nichlock/open-linear-scale/docs/4-layer-sensor-noise-raw.png

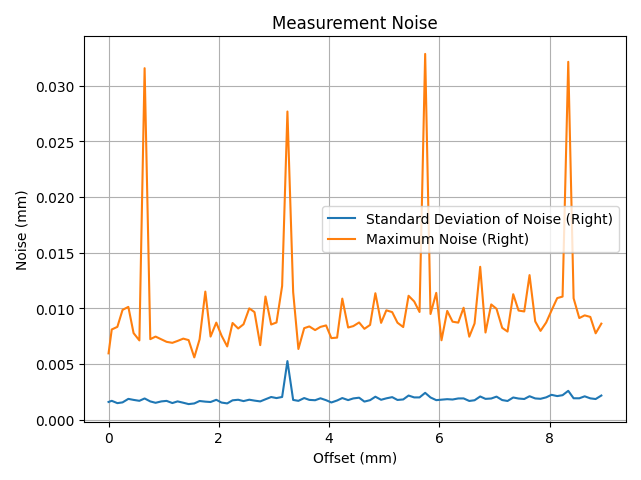
docs/4-layer-sensor-noise-raw.png
