nichlock/open-linear-scale/docs/bare-sensor-top.jpg

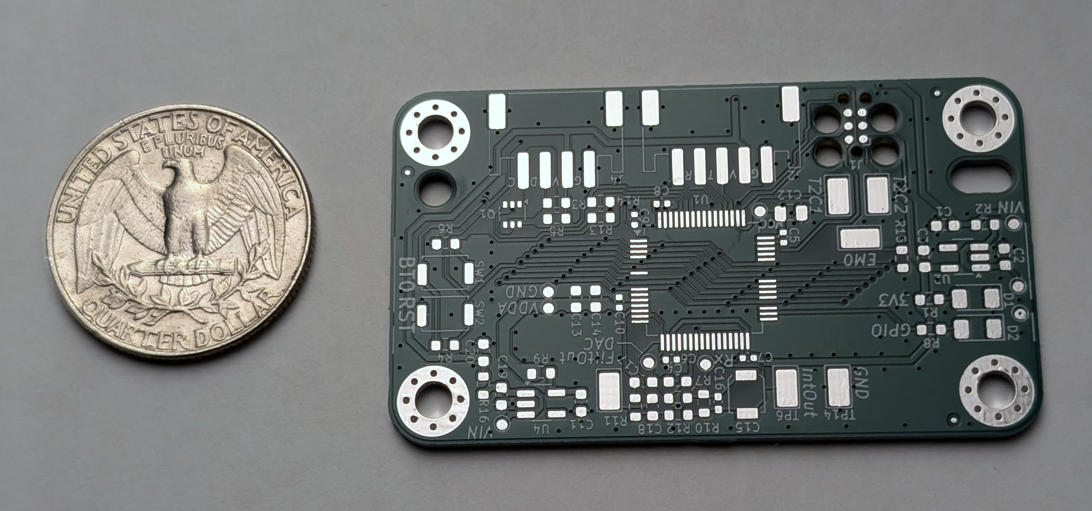
docs/bare-sensor-top.jpg
