nichlock/open-linear-scale/docs/header-bg-removed.png

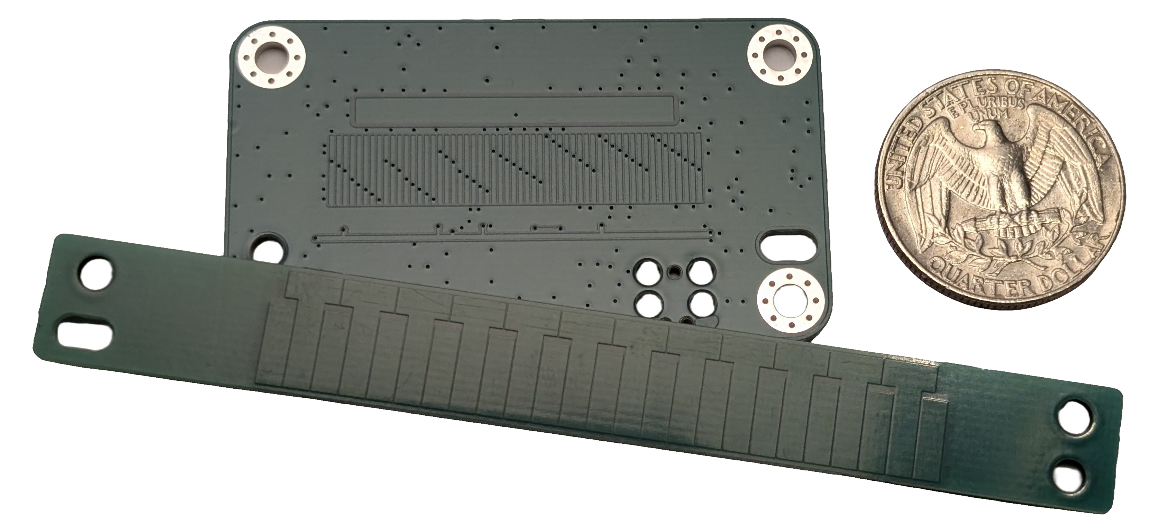
docs/header-bg-removed.png
