nichlock/open-linear-scale/docs/header-no-bg-removed.png

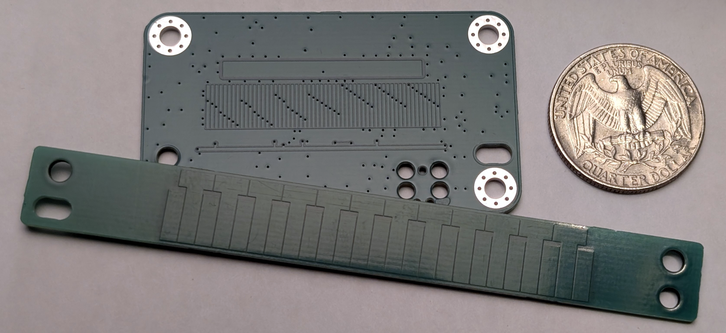
docs/header-no-bg-removed.png
