nichlock/open-linear-scale/docs/overlap/detail.png

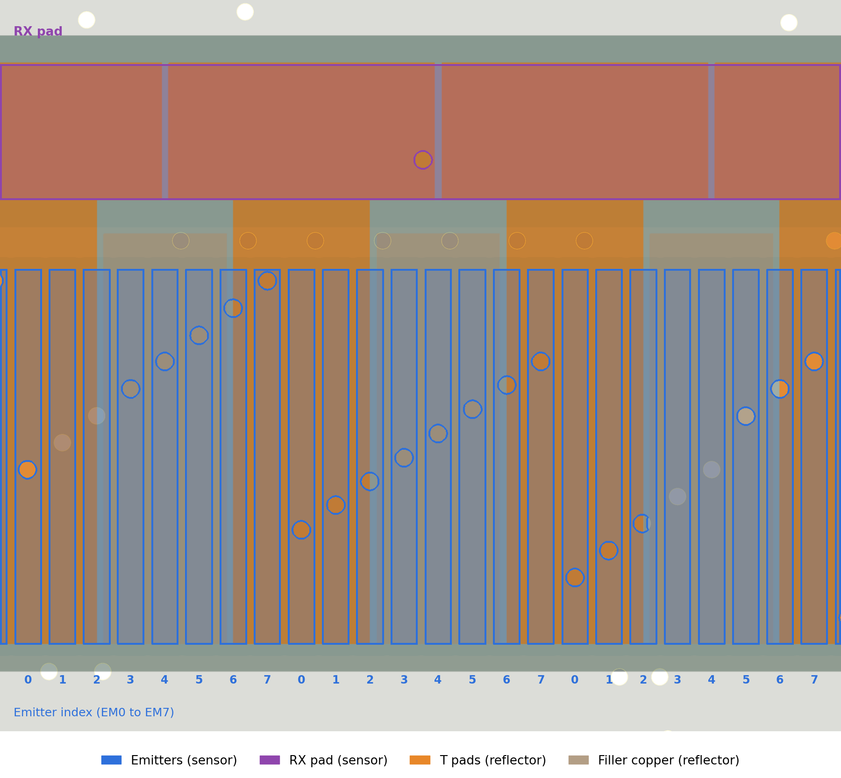
docs/overlap/detail.png
