nichlock/open-linear-scale/docs/overlap/reflector-pad-side.png

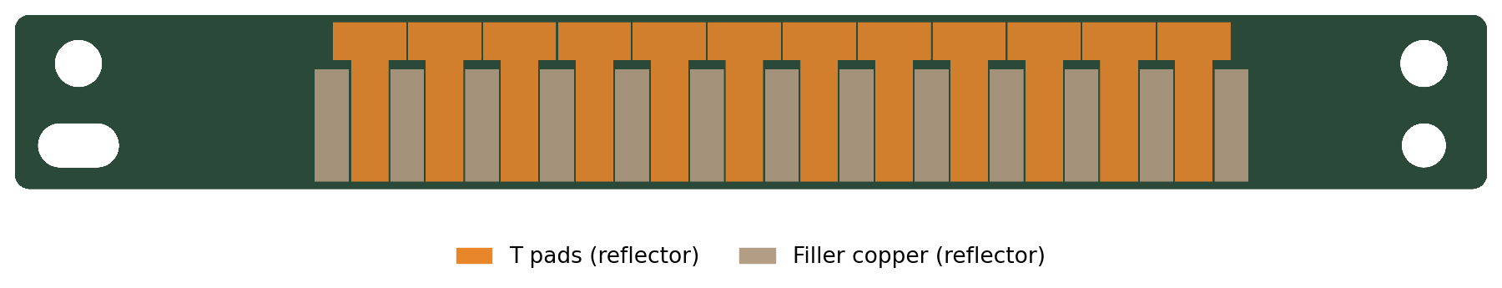
docs/overlap/reflector-pad-side.png
