nichlock/open-linear-scale/docs/overlap/sensor-grid-side.png

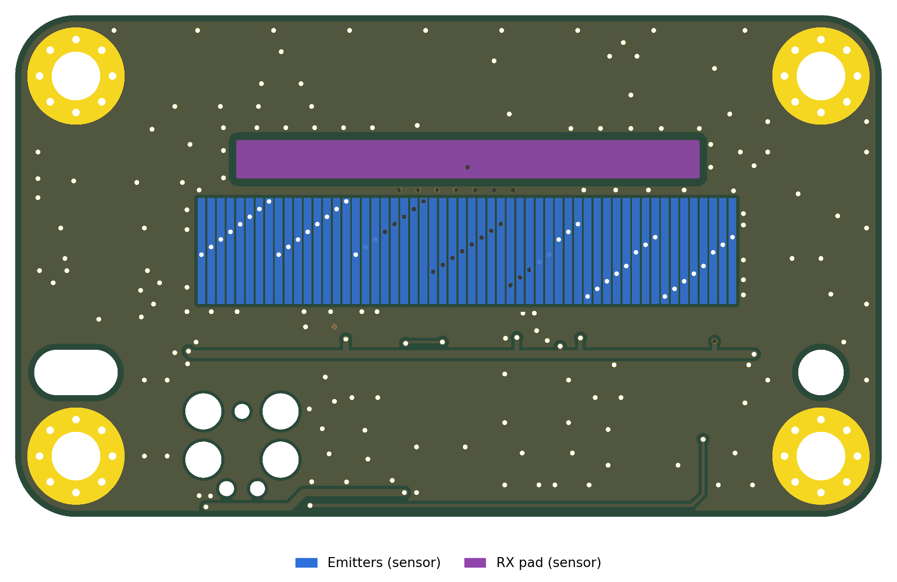
docs/overlap/sensor-grid-side.png
