nichlock/open-linear-scale/docs/pinout/sensor-pinout.png

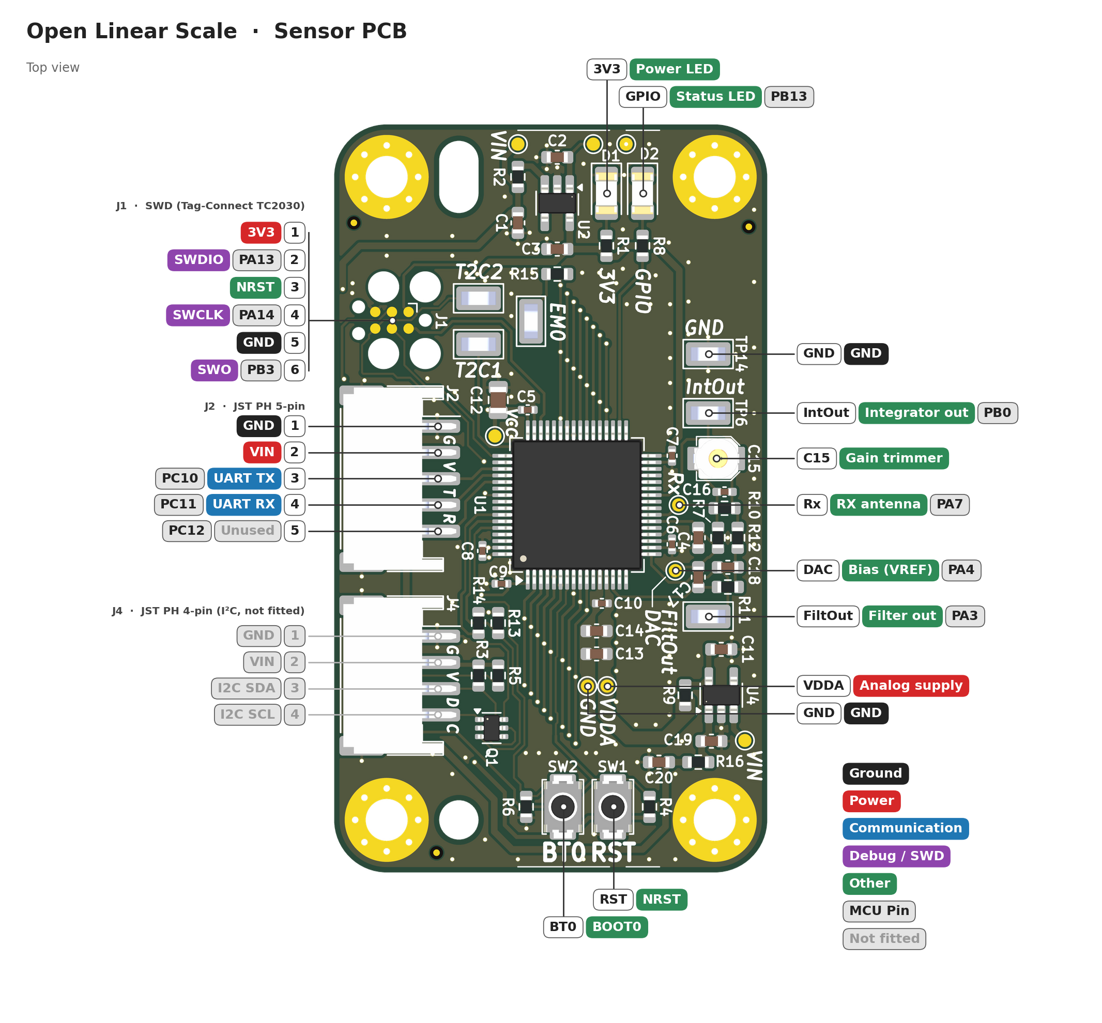
docs/pinout/sensor-pinout.png
