nichlock/open-linear-scale/docs/plots/emitter-state-transitions.png

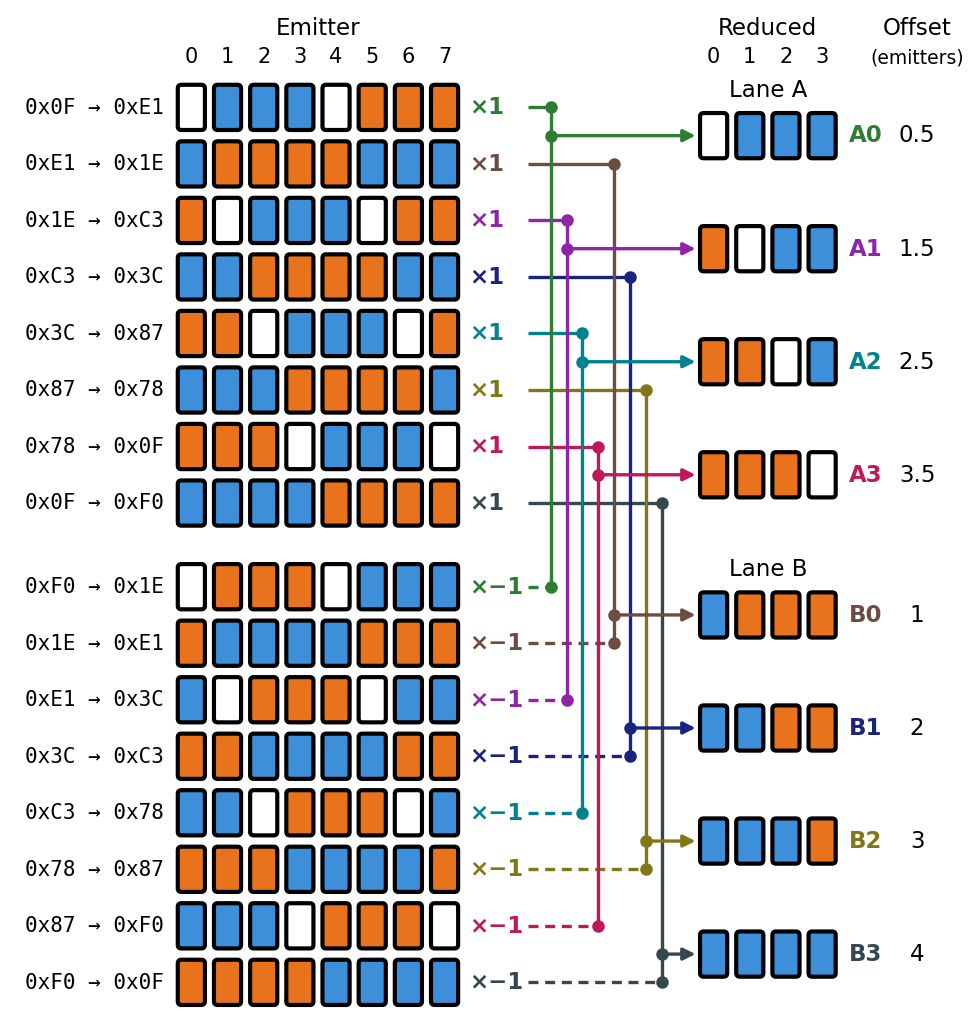
docs/plots/emitter-state-transitions.png
