nichlock/open-linear-scale/docs/sensor-pcb-bot-quarter.jpg

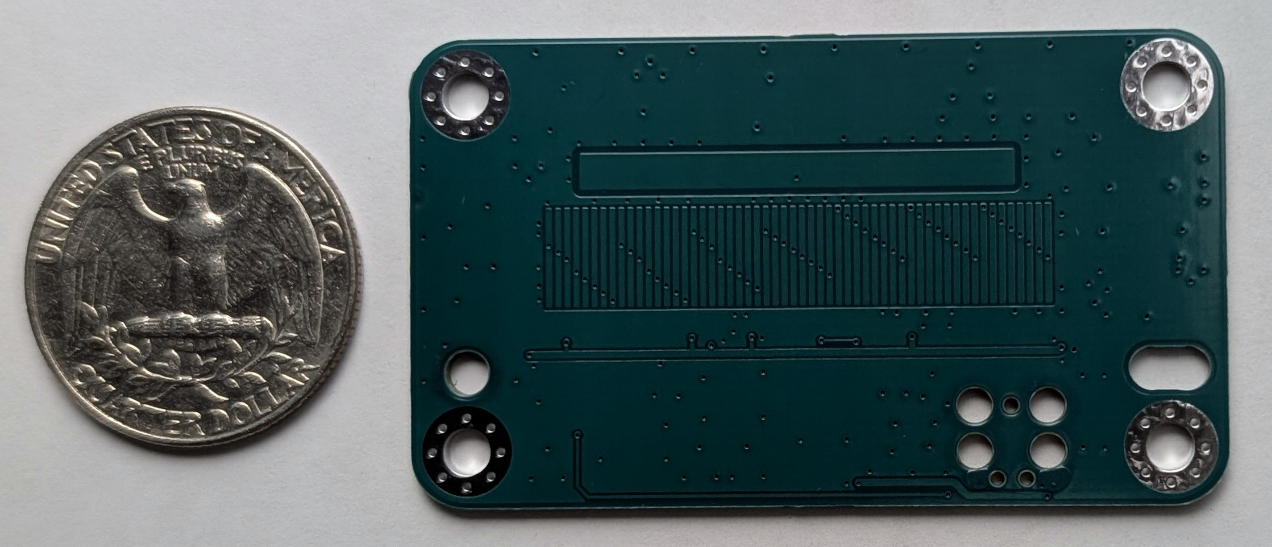
docs/sensor-pcb-bot-quarter.jpg
