nichlock/open-linear-scale/docs/sensor-pcb-bot.jpg

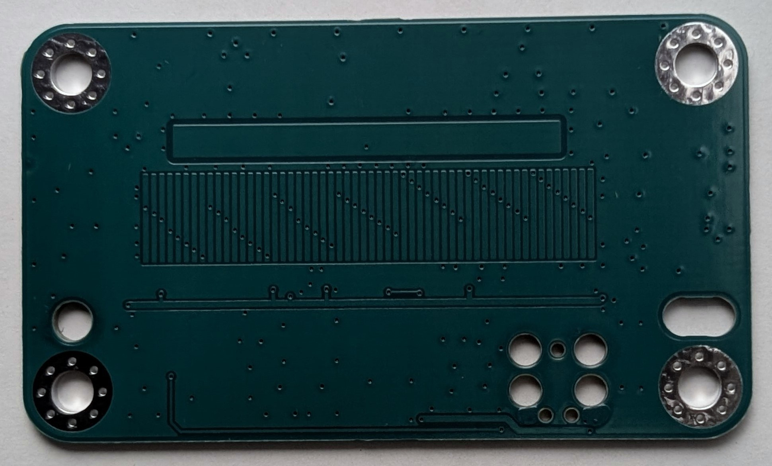
docs/sensor-pcb-bot.jpg
