nichlock/open-linear-scale/hardware/sensor-pcb/sensor-pcb.csv

# | Reference | Qty | Value | DNP | Footprint | MFPN | Digi-Key PN | Notes
1 | C1,C2,C3,C4,C11,C13,C14,C19,C20 | 9 | 1uF |  | Capacitor_SMD:C_0603_1608Metric | GCM188R71E105KA64D | 490-10673-1-ND
2 | C5,C6,C7,C8,C9,C10 | 6 | 0.1uF |  | Capacitor_SMD:C_0402_1005Metric | GCM155R71C104KA55D | 490-4759-1-ND
3 | C12 | 1 | 4.7uF |  | Capacitor_SMD:C_0805_2012Metric | GCM21BR71C475KA73L | 490-5332-1-ND
4 | C15 | 1 | JR030 |  | JRx-trimmer:JRx-trimmer | JR030 | 1674-1015-1-ND
5 | C16 | 1 | 1pF | DNP | Capacitor_SMD:C_0402_1005Metric_Pad0.74x0.62mm_HandSolder | GCM1555C1H1R0CA16J | 490-17745-1-ND
6 | C17 | 1 | 1.1nF |  | Capacitor_SMD:C_0603_1608Metric | GCM1885G1H112FA16D | 490-GCM1885G1H112FA16DCT-ND
7 | C18 | 1 | 2.2nF |  | Capacitor_SMD:C_0603_1608Metric | GCM1885C1H222FA16D | 490-16421-1-ND
8 | D1 | 1 | APT3216LZGCK |  | LED_SMD:LED_1206_3216Metric | APT3216LZGCK | 754-1944-1-ND
9 | D2 | 1 | APT3216LSECK/J3-PRV |  | LED_SMD:LED_1206_3216Metric | APT3216LSECK/J3-PRV | 754-1940-1-ND
10 | J2 | 1 | S5B-PH-SM4-TB |  | Connector_JST:JST_PH_S5B-PH-SM4-TB_1x05-1MP_P2.00mm_Horizontal | S5B-PH-SM4-TB | 455-S5B-PH-SM4-TBCT-ND
11 | J4 | 1 | S4B-PH-SM4-TB | DNP | Connector_JST:JST_PH_S4B-PH-SM4-TB_1x04-1MP_P2.00mm_Horizontal | S4B-PH-SM4-TB | 455-S4B-PH-SM4-TBCT-ND
12 | M1 | 1 | PHR-5 |  |  | PHR-5 | 455-1163-ND
13 | M2,M3,M4,M5,M6 | 5 | ASPHSPH24K102 |  |  | ASPHSPH24K102 | 455-3358-ND | You can buy kits of knock-off JST PH parts, but I chose to buy the official pre-crimped wires.
14 | Q1 | 1 | BSS138BKSH | DNP | Package_TO_SOT_SMD:SOT-363_SC-70-6 | BSS138BKSH | 1727-7841-1-ND
15 | R1,R8 | 2 | 510 |  | Resistor_SMD:R_0603_1608Metric | CRCW0603510RFKEA | 541-510HCT-ND
16 | R2,R9,R16 | 3 | 0R |  | Resistor_SMD:R_0603_1608Metric | CRCW06030000Z0EA | 541-0.0GCT-ND
17 | R3,R5,R13,R14 | 4 | 10k | DNP | Resistor_SMD:R_0603_1608Metric | CRCW060310K0FKEA | 541-10.0KHCT-ND
18 | R4,R6 | 2 | 5.1k |  | Resistor_SMD:R_0603_1608Metric | CRCW06035K10FKEA | 541-5.10KHCT-ND
19 | R7 | 1 | 680k |  | Resistor_SMD:R_0603_1608Metric | CRCW0603680KFKEA | 541-680KHCT-ND
20 | R10 | 1 | 100M |  | Resistor_SMD:R_0603_1608Metric | CRCW0603100MJPEAHR | 541-100MAHCT-ND
21 | R11,R12,R15 | 3 | 10k |  | Resistor_SMD:R_0603_1608Metric | CRCW060310K0FKEA | 541-10.0KHCT-ND
22 | SW1,SW2 | 2 | SKRKAHE020 |  | Button_Switch_SMD:SW_Push_SPST_NO_Alps_SKRK | SKRKAHE020 | 4809-SKRKAHE020CT-ND
23 | TP6,TP8,TP10,TP12,TP14,TP17 | 6 | TP_Keystone_5015 |  | TestPoint:TestPoint_Keystone_5015_Micro_Mini | 5015 | 36-5015CT-ND
24 | U1 | 1 | STM32L476RCTx |  | Package_QFP:LQFP-64_10x10mm_P0.5mm | STM32L476RCT6 | 497-17541-ND
25 | U2,U4 | 2 | AP7354-33W5-7 |  | Package_TO_SOT_SMD:SOT-23-5_HandSoldering | AP7354-33W5-7 | AP7354-33W5-7DICT-ND
