nichlock/open-linear-scale/mechanical/Full Reflector 0.1mm.stl

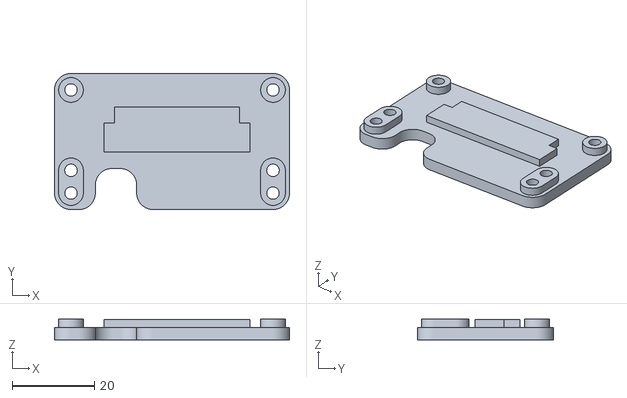
[picture p38: CAD file, 2026-10-06]
mechanical/Full Reflector 0.1mm.stl
57.0 x 33.0 x 5.00
