nichlock/open-linear-scale/mechanical/Full Reflector 0.3mm.stl

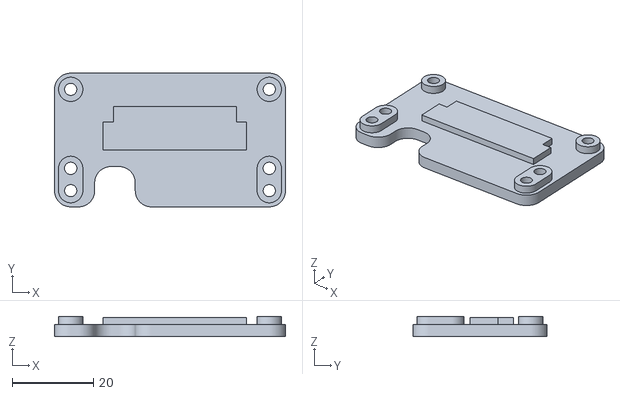
[picture p39: CAD file, 2026-10-06]
mechanical/Full Reflector 0.3mm.stl
57.0 x 33.0 x 5.00
