nichlock/open-linear-scale/hardware/reflector-pcb-sm/exports/reflector-pcb-sm.step

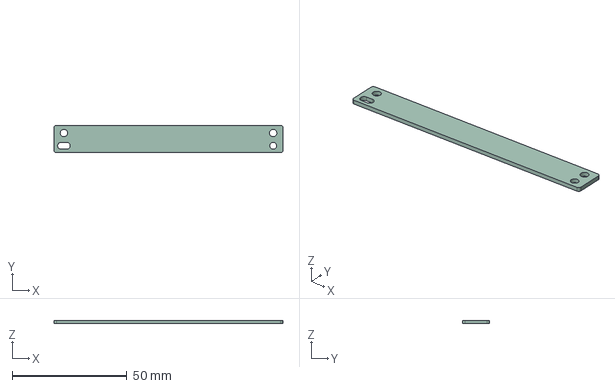
[picture p40: CAD file, 2026-10-12]
hardware/reflector-pcb-sm/exports/reflector-pcb-sm.step
99.8 x 11.8 x 1.51 mm
