nichlock/open-linear-scale/hardware/sensor-pcb/exports/sensor-pcb.step

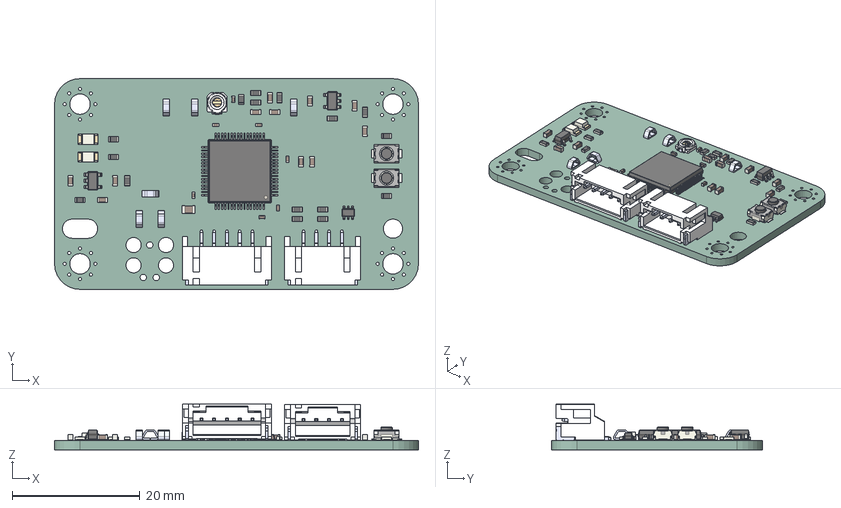
[picture p41: CAD file, 2026-10-13]
hardware/sensor-pcb/exports/sensor-pcb.step
57.0 x 33.0 x 7.19 mm
C_0603_1608Metric x 11
R_0603_1608Metric x 16
SxB-PH-SM4-TB white_4
C_0402_1005Metric x 7
SOT-363_SC-70-6
LED_1206_3216Metric x 2
SW_Push_SPST_NO_Alps_SKRK x 2
LQFP-64_10x10mm_P0.5mm
SOT-23-5 x 2
S5B-PH-SM4-TB
JR200
C_0805_2012Metric
sensor-pcb_PCB
