nichlock/open-linear-scale/mechanical/calibration-prusa/Indicator-Clamp.stl

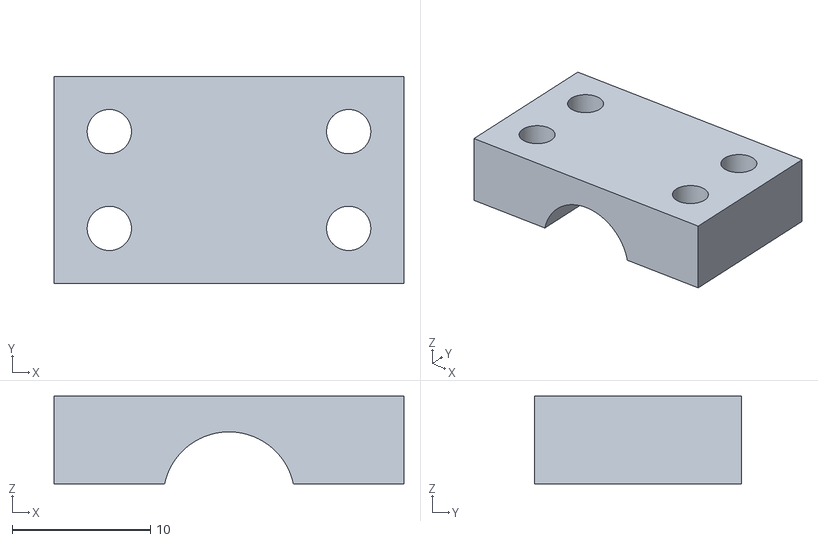
[picture p42: CAD file, 2026-10-11]
mechanical/calibration-prusa/Indicator-Clamp.stl
25.3 x 15.0 x 6.34
