nichlock/open-linear-scale/mechanical/calibration/Rear Bracket.stl

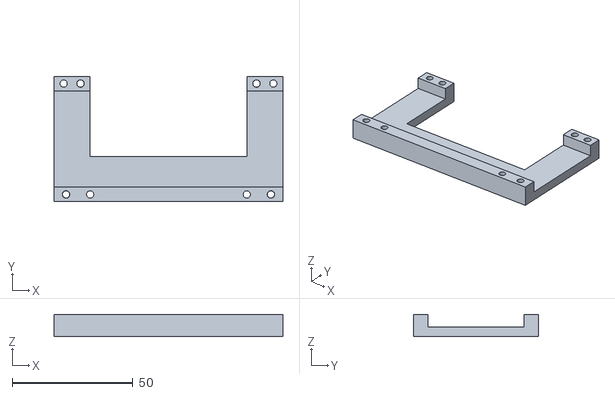
[picture p43: CAD file, 2026-10-04]
mechanical/calibration/Rear Bracket.stl
95.0 x 52.0 x 9.20
