nichlock/open-linear-scale/mechanical/freestanding/Shim.stl

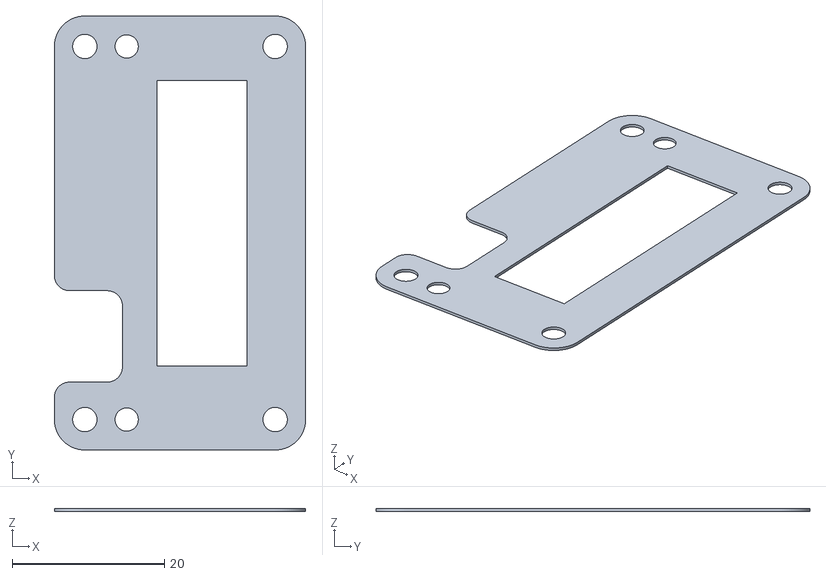
[picture p44: CAD file, 2026-10-04]
mechanical/freestanding/Shim.stl
33.0 x 57.0 x 0.39
