nichlock/open-linear-scale/mechanical/calibration-prusa/calibration-prusa.step

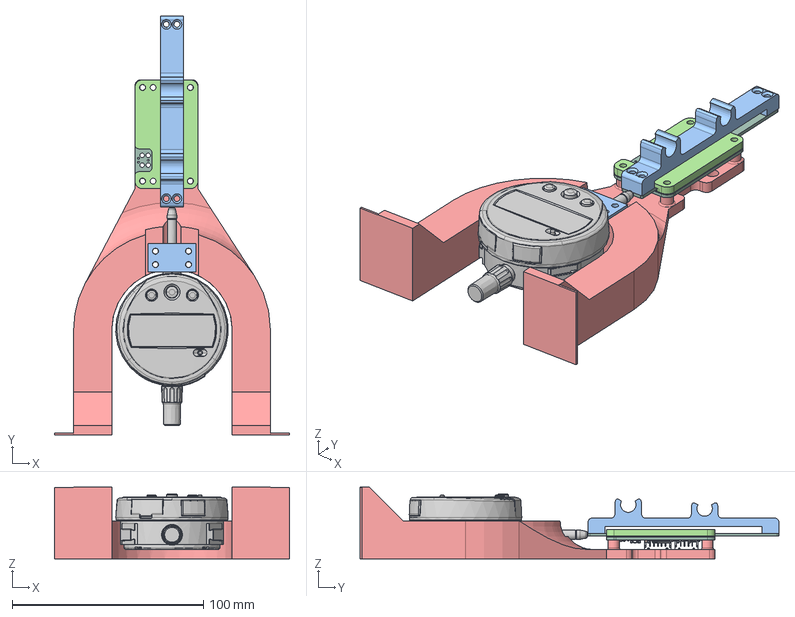
[picture p45: CAD file, 2026-10-11]
mechanical/calibration-prusa/calibration-prusa.step
123.0 x 219.1 x 37.7 mm
reflector-pcb-sm_PCB
Top
C_0603_1608Metric x 11
R_0603_1608Metric x 16
SxB-PH-SM4-TB white_4
C_0402_1005Metric x 7
SOT-363_SC-70-6
LED_1206_3216Metric x 2
SW_Push_SPST_NO_Alps_SKRK x 2
LQFP-64_10x10mm_P0.5mm
SOT-23-5 x 2
JR200
S5B-PH-SM4-TB
C_0805_2012Metric
sensor-pcb_PCB
