nichlock/open-linear-scale/mechanical/calibration/Sensor Mount.stl

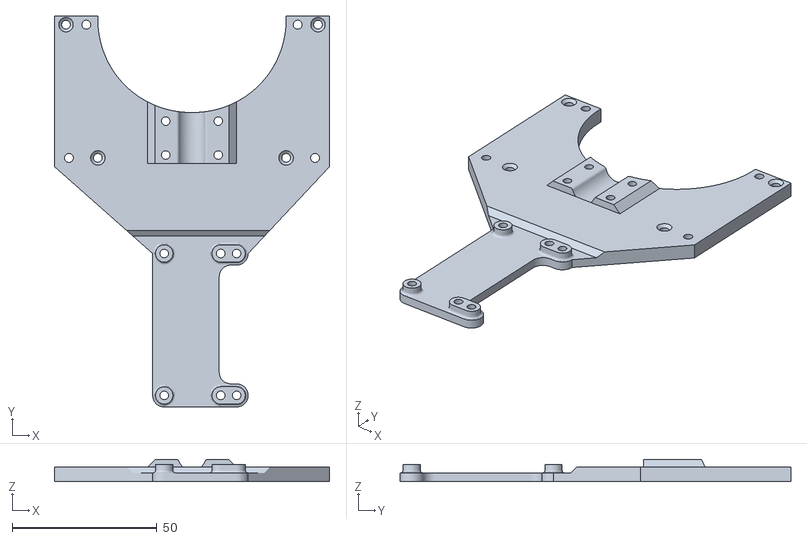
[picture p46: CAD file, 2026-10-04]
mechanical/calibration/Sensor Mount.stl
95.0 x 135.0 x 7.60
