nichlock/open-linear-scale/mechanical/freestanding/Alignment.stl

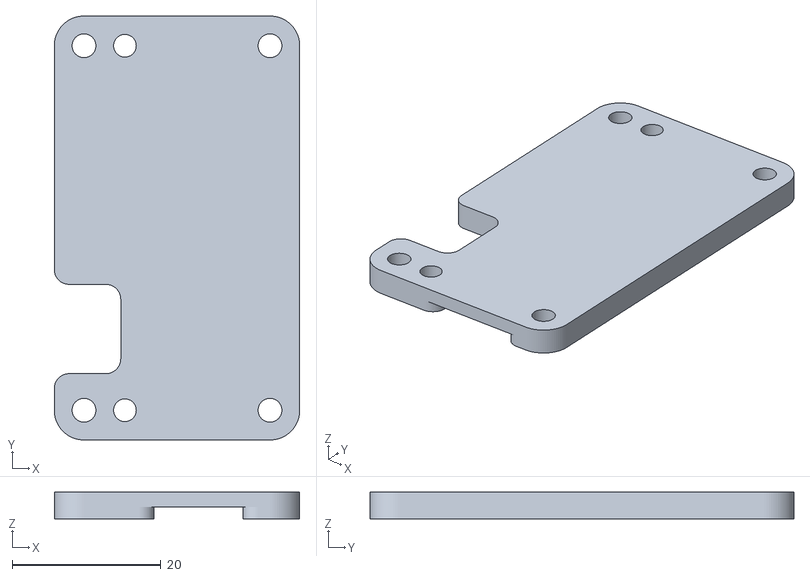
[picture p47: CAD file, 2026-10-04]
mechanical/freestanding/Alignment.stl
33.0 x 57.0 x 3.61
