nichlock/open-linear-scale/mechanical/calibration-prusa/Frame.stl

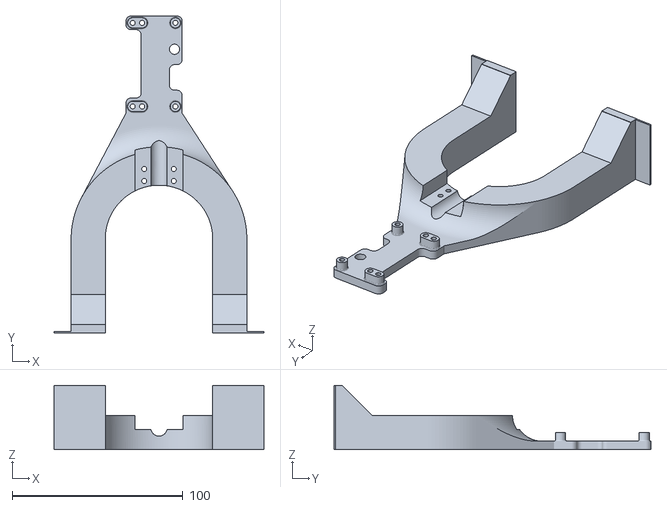
[picture p48: CAD file, 2026-10-11]
mechanical/calibration-prusa/Frame.stl
123.0 x 185.8 x 37.7
