nichlock/open-linear-scale/mechanical/calibration/Reflector Mount.stl

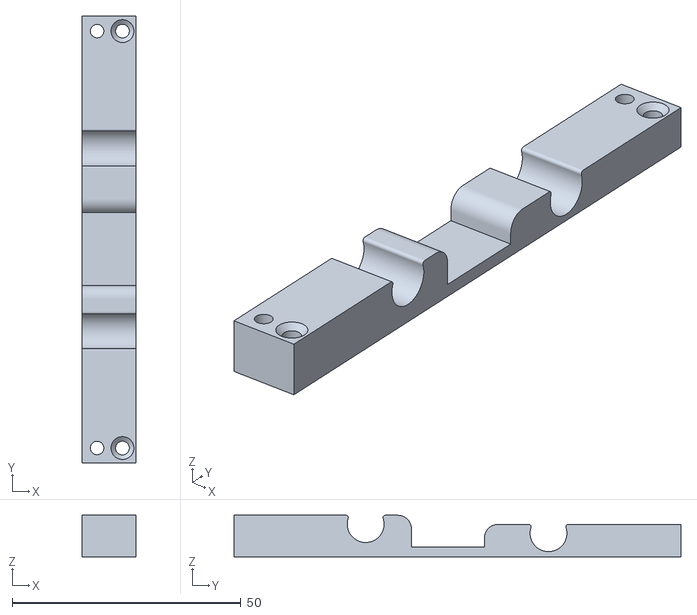
[picture p49: CAD file, 2026-10-04]
mechanical/calibration/Reflector Mount.stl
11.8 x 97.8 x 9.09
