nichlock/open-linear-scale/mechanical/freestanding/Reflector Pusher.stl

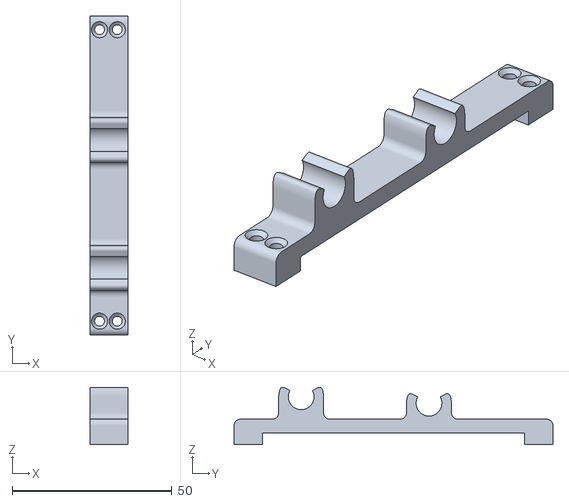
[picture p50: CAD file, 2026-10-04]
mechanical/freestanding/Reflector Pusher.stl
11.8 x 99.8 x 18.0
