nichlock/open-linear-scale/mechanical/calibration/Indicator Clamp.stl

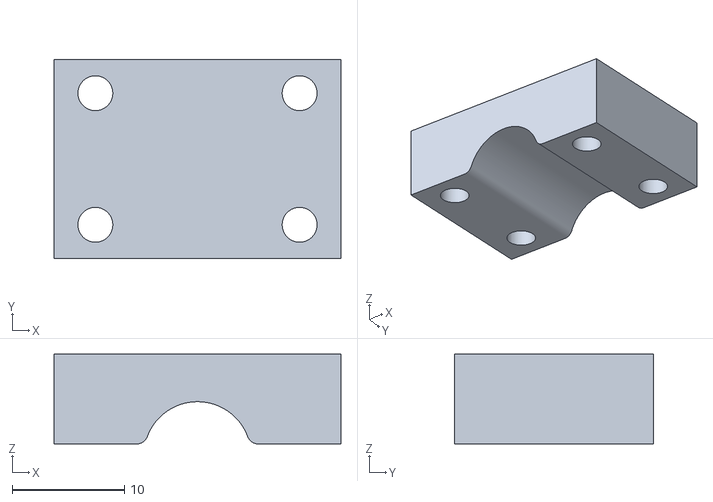
[picture p51: CAD file, 2026-10-04]
mechanical/calibration/Indicator Clamp.stl
25.5 x 17.7 x 8.00
