nichlock/open-linear-scale/(list of files, cad)

Other CAD files:
mechanical/Full Reflector 0.4mm.stl
mechanical/Full Reflector 0.2mm.stl
mechanical/freestanding/Frame.stl
hardware/reflector-pcb-sm/reflector-pcb-sm.step
hardware/sensor-pcb/sensor-pcb.step
mechanical/calibration-prusa/calibration-prusa.f3z
