nichlock/open-linear-scale/mechanical/calibration-prusa/assembly-photos/1-cal-prusa-unassembled.jpg

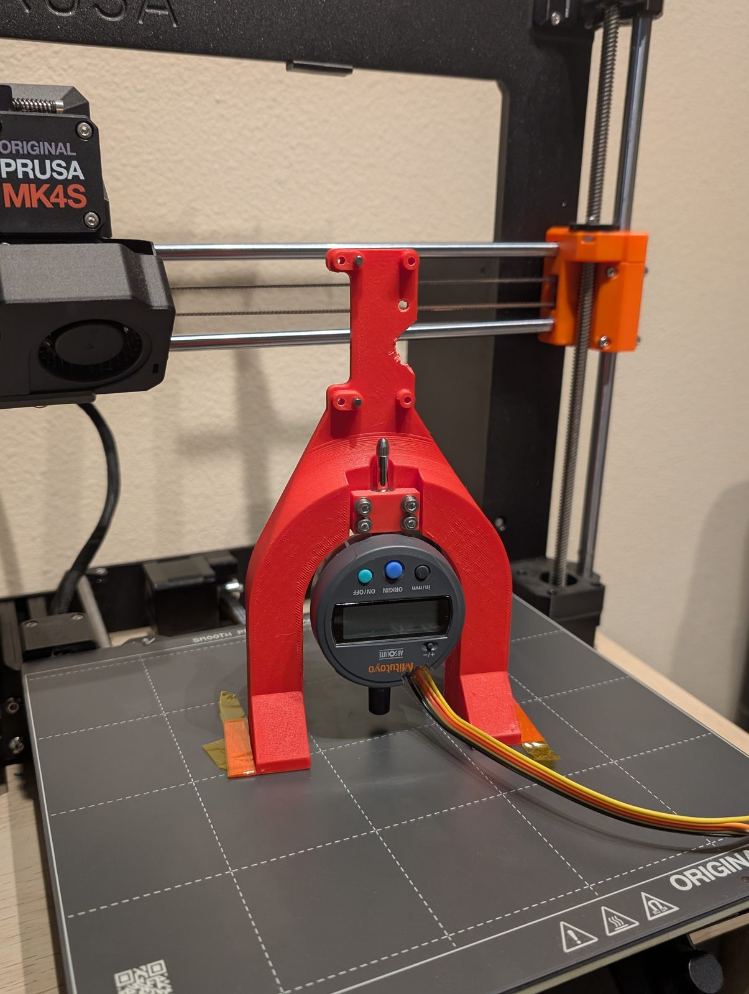
mechanical/calibration-prusa/assembly-photos/1-cal-prusa-unassembled.jpg
