nichlock/open-linear-scale/mechanical/calibration-prusa/assembly-photos/3-cal-prusa-with-housing.jpg

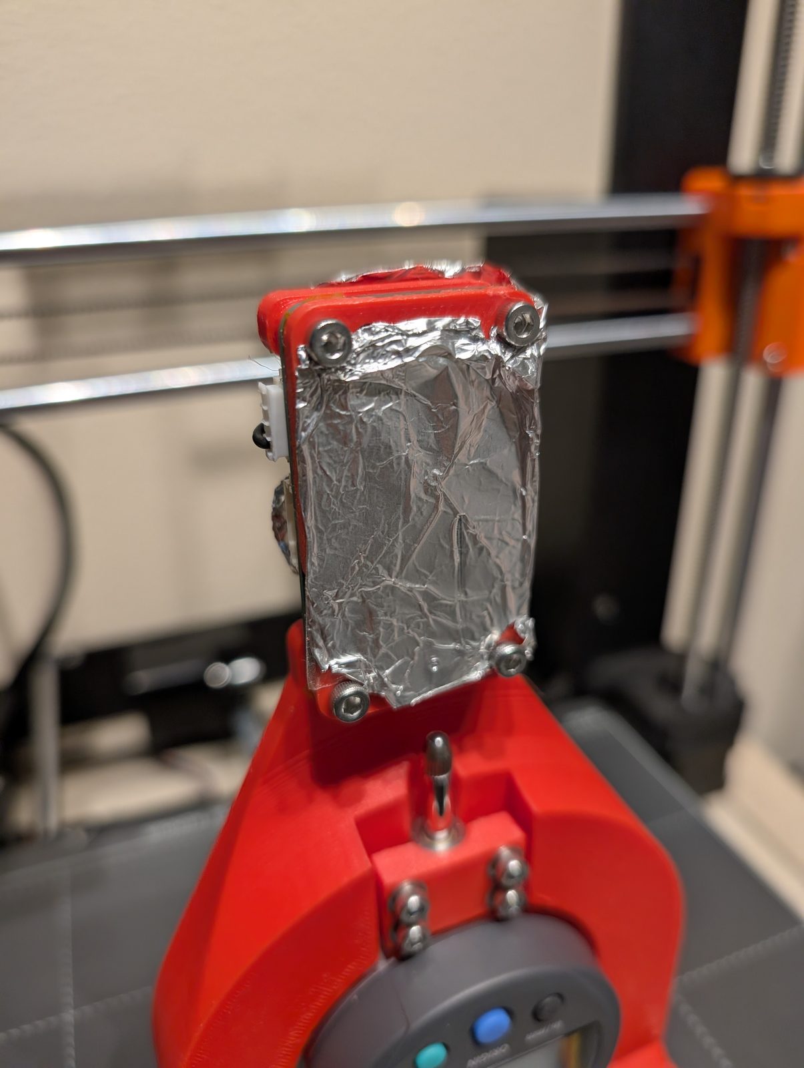
mechanical/calibration-prusa/assembly-photos/3-cal-prusa-with-housing.jpg
