nichlock/open-linear-scale/mechanical/calibration-prusa/assembly-photos/4-cal-prusa-with-housing-shield-closeup.jpg

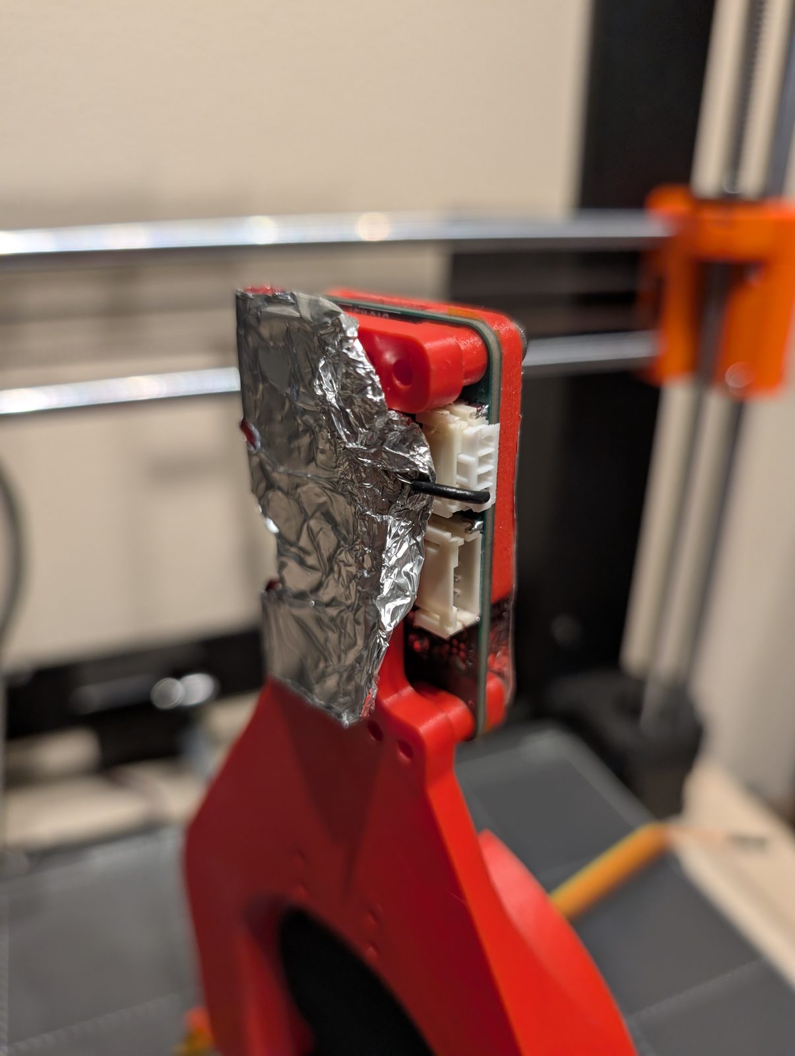
mechanical/calibration-prusa/assembly-photos/4-cal-prusa-with-housing-shield-closeup.jpg
