nichlock/open-linear-scale/mechanical/calibration-prusa/assembly-photos/5a-cal-prusa-with-reflector.jpg

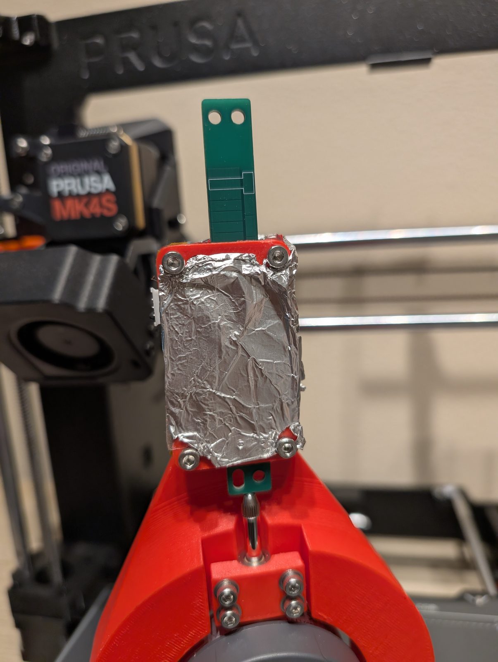
mechanical/calibration-prusa/assembly-photos/5a-cal-prusa-with-reflector.jpg
