nichlock/open-linear-scale/mechanical/calibration-prusa/assembly-photos/5b-cal-prusa-reflector-far-away.jpg

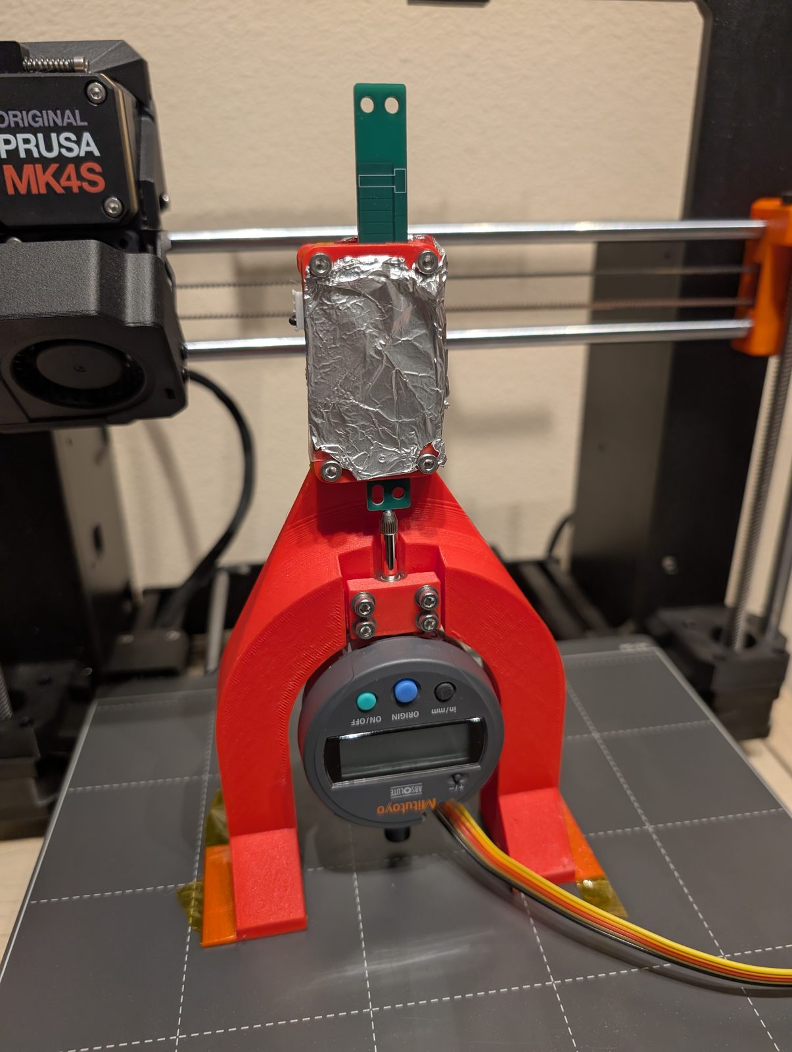
mechanical/calibration-prusa/assembly-photos/5b-cal-prusa-reflector-far-away.jpg
