nichlock/open-linear-scale/mechanical/calibration-prusa/assembly-photos/7-cal-prusa-reflector-mount-alignment.jpg

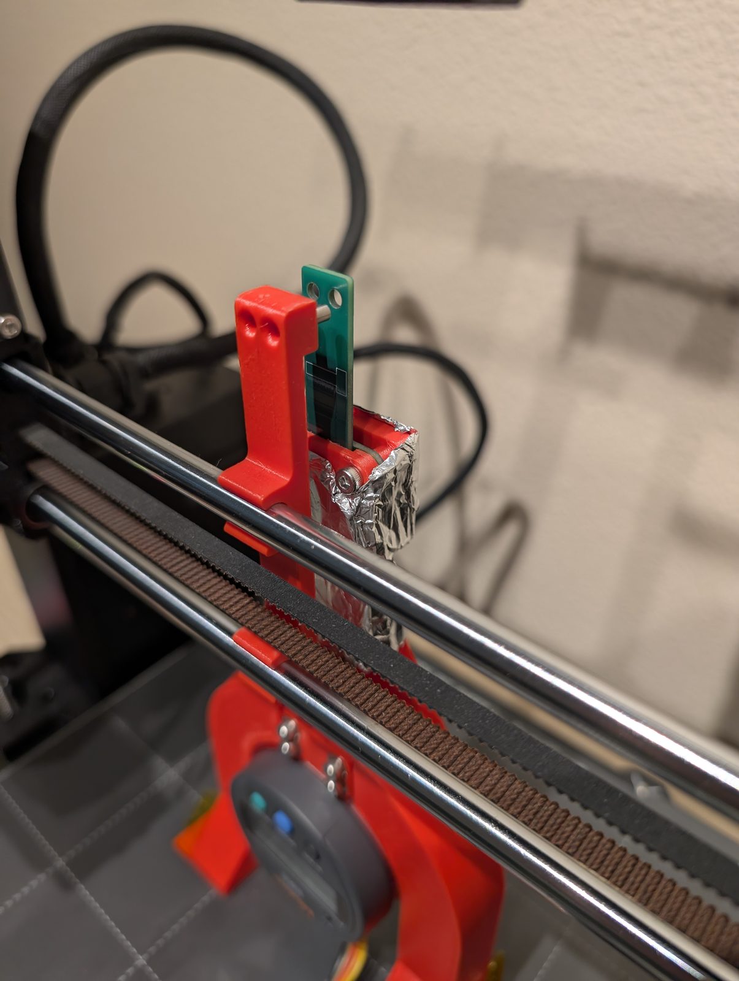
mechanical/calibration-prusa/assembly-photos/7-cal-prusa-reflector-mount-alignment.jpg
