nichlock/open-linear-scale/mechanical/calibration-prusa/assembly-photos/8-cal-prusa-reflector-mount-installed.jpg

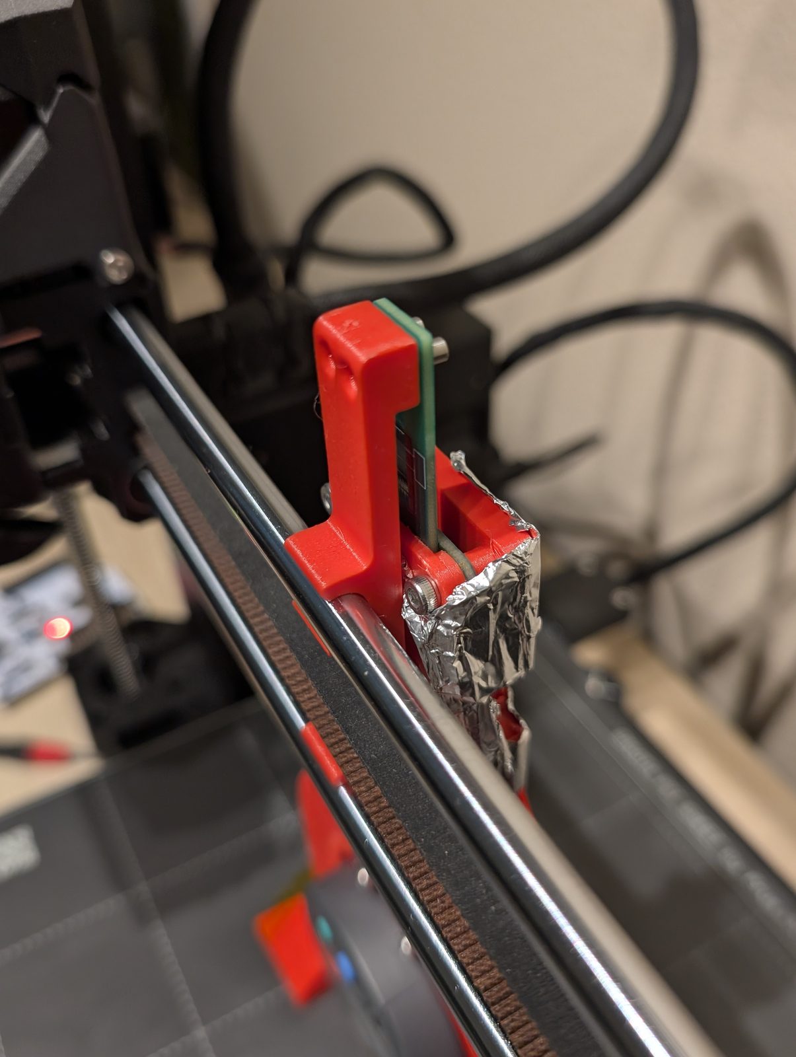
mechanical/calibration-prusa/assembly-photos/8-cal-prusa-reflector-mount-installed.jpg
