nichlock/open-linear-scale/mechanical/calibration-prusa/assembly-photos/9-cal-prusa-reflector-pins-bottom.jpg

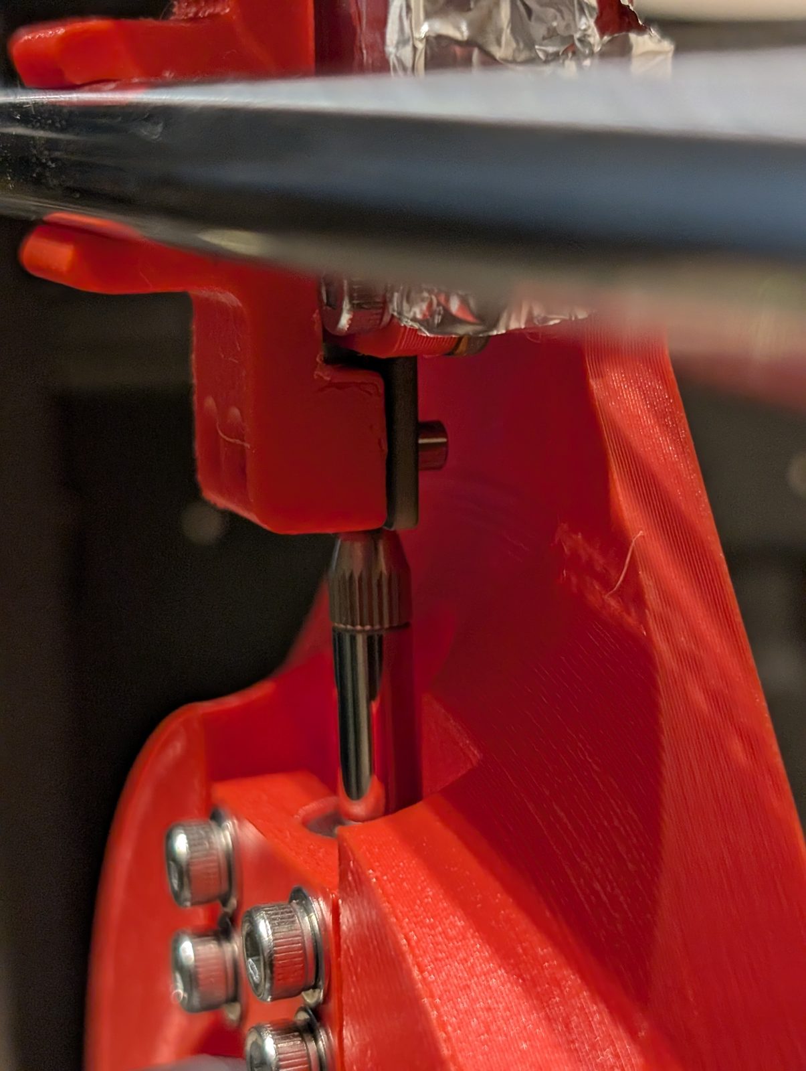
mechanical/calibration-prusa/assembly-photos/9-cal-prusa-reflector-pins-bottom.jpg
