nichlock/open-linear-scale/mechanical/calibration-prusa/assembly-photos/10-cal-prusa-assembled.jpg

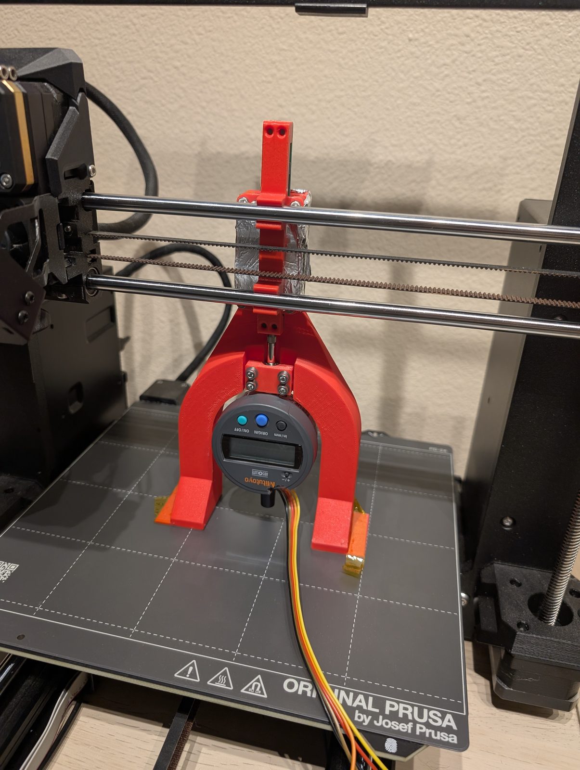
mechanical/calibration-prusa/assembly-photos/10-cal-prusa-assembled.jpg
