nichlock/open-linear-scale/mechanical/calibration-prusa/assembly-photos/12-cal-prusa-nucleo.jpg

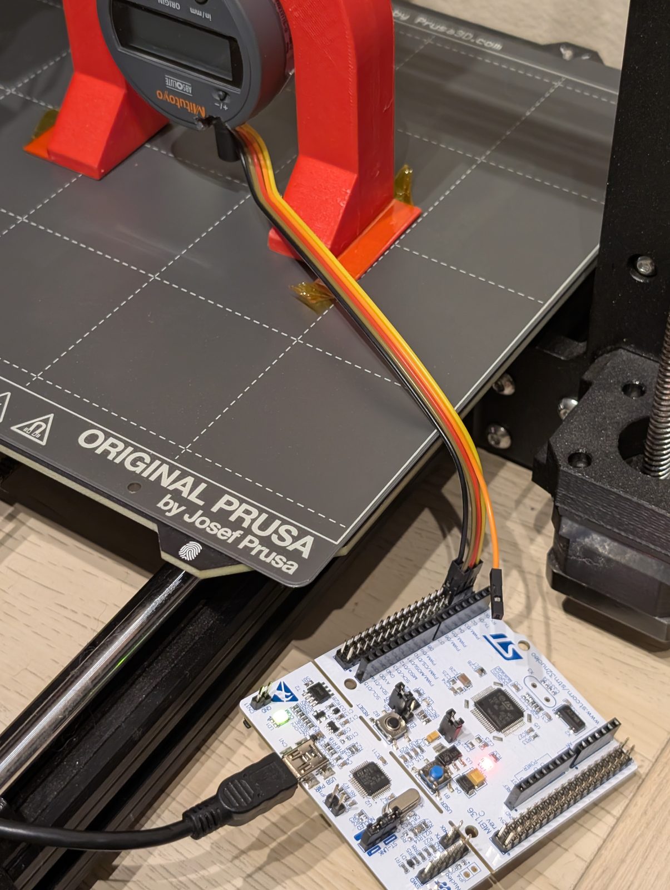
mechanical/calibration-prusa/assembly-photos/12-cal-prusa-nucleo.jpg
