nichlock/open-linear-scale/mechanical/calibration-prusa/assembly-photos/mitutoyo-wiring.jpg

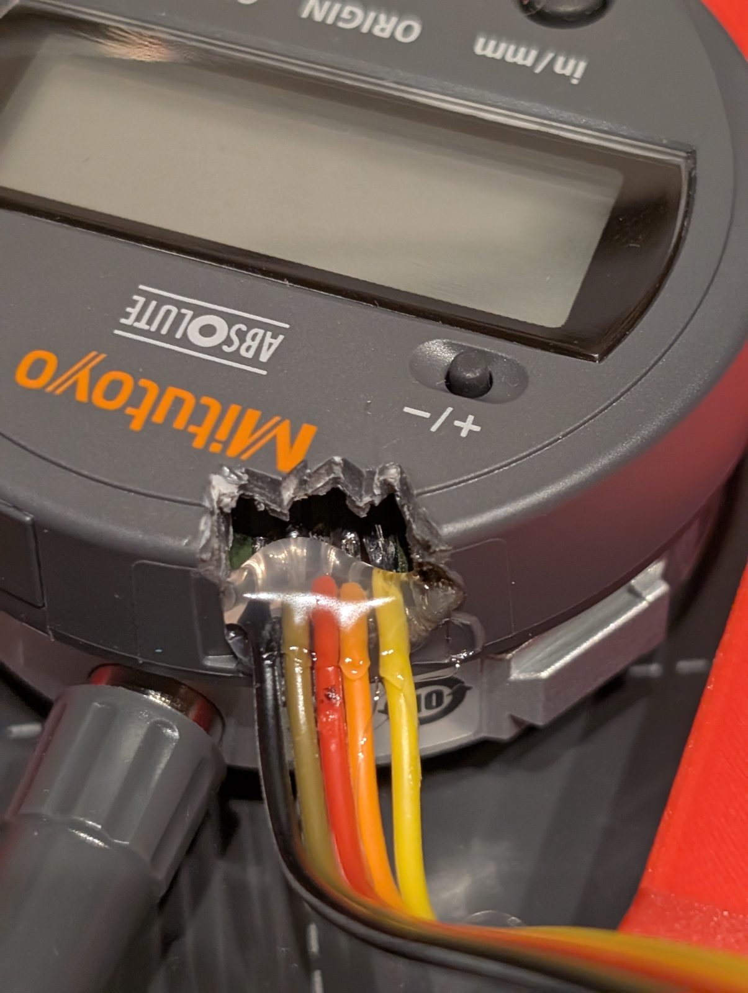
mechanical/calibration-prusa/assembly-photos/mitutoyo-wiring.jpg
