nichlock/open-linear-scale/docs/mechanical/overall-calibration-assy-front.PNG

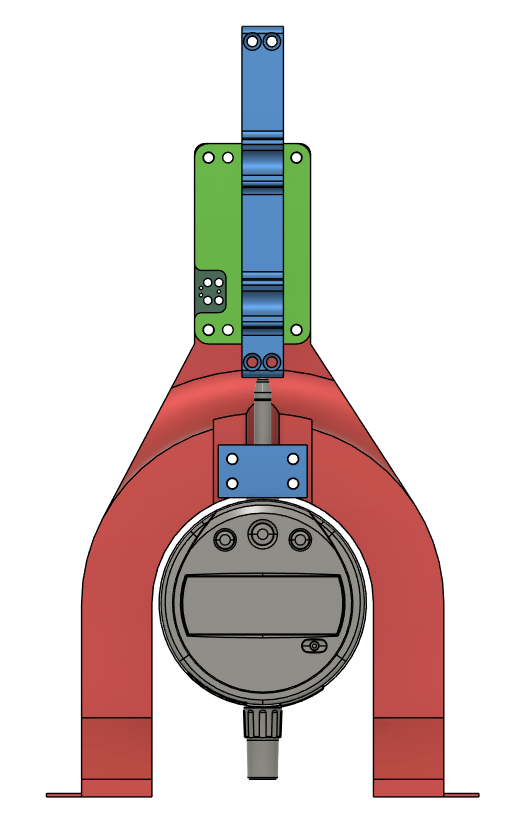
docs/mechanical/overall-calibration-assy-front.PNG
