nichlock/open-linear-scale/docs/mechanical/overall-calibration-assy.PNG

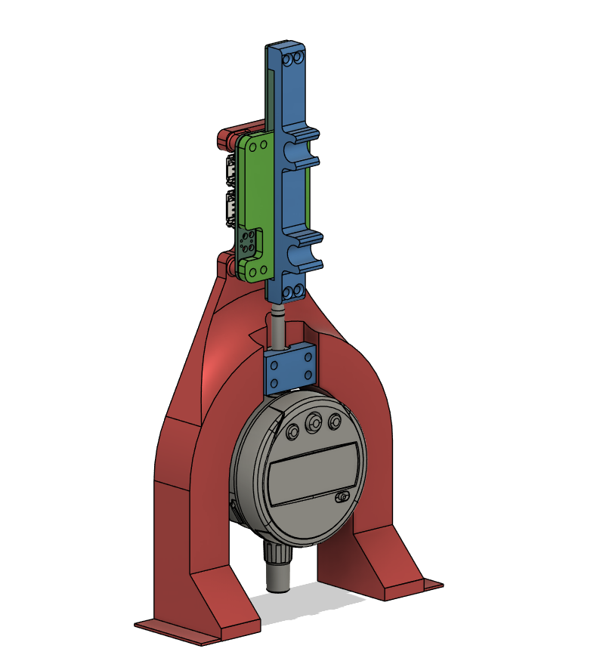
docs/mechanical/overall-calibration-assy.PNG
