nichlock/open-linear-scale/mechanical/pcb-alignment-drawing.pdf

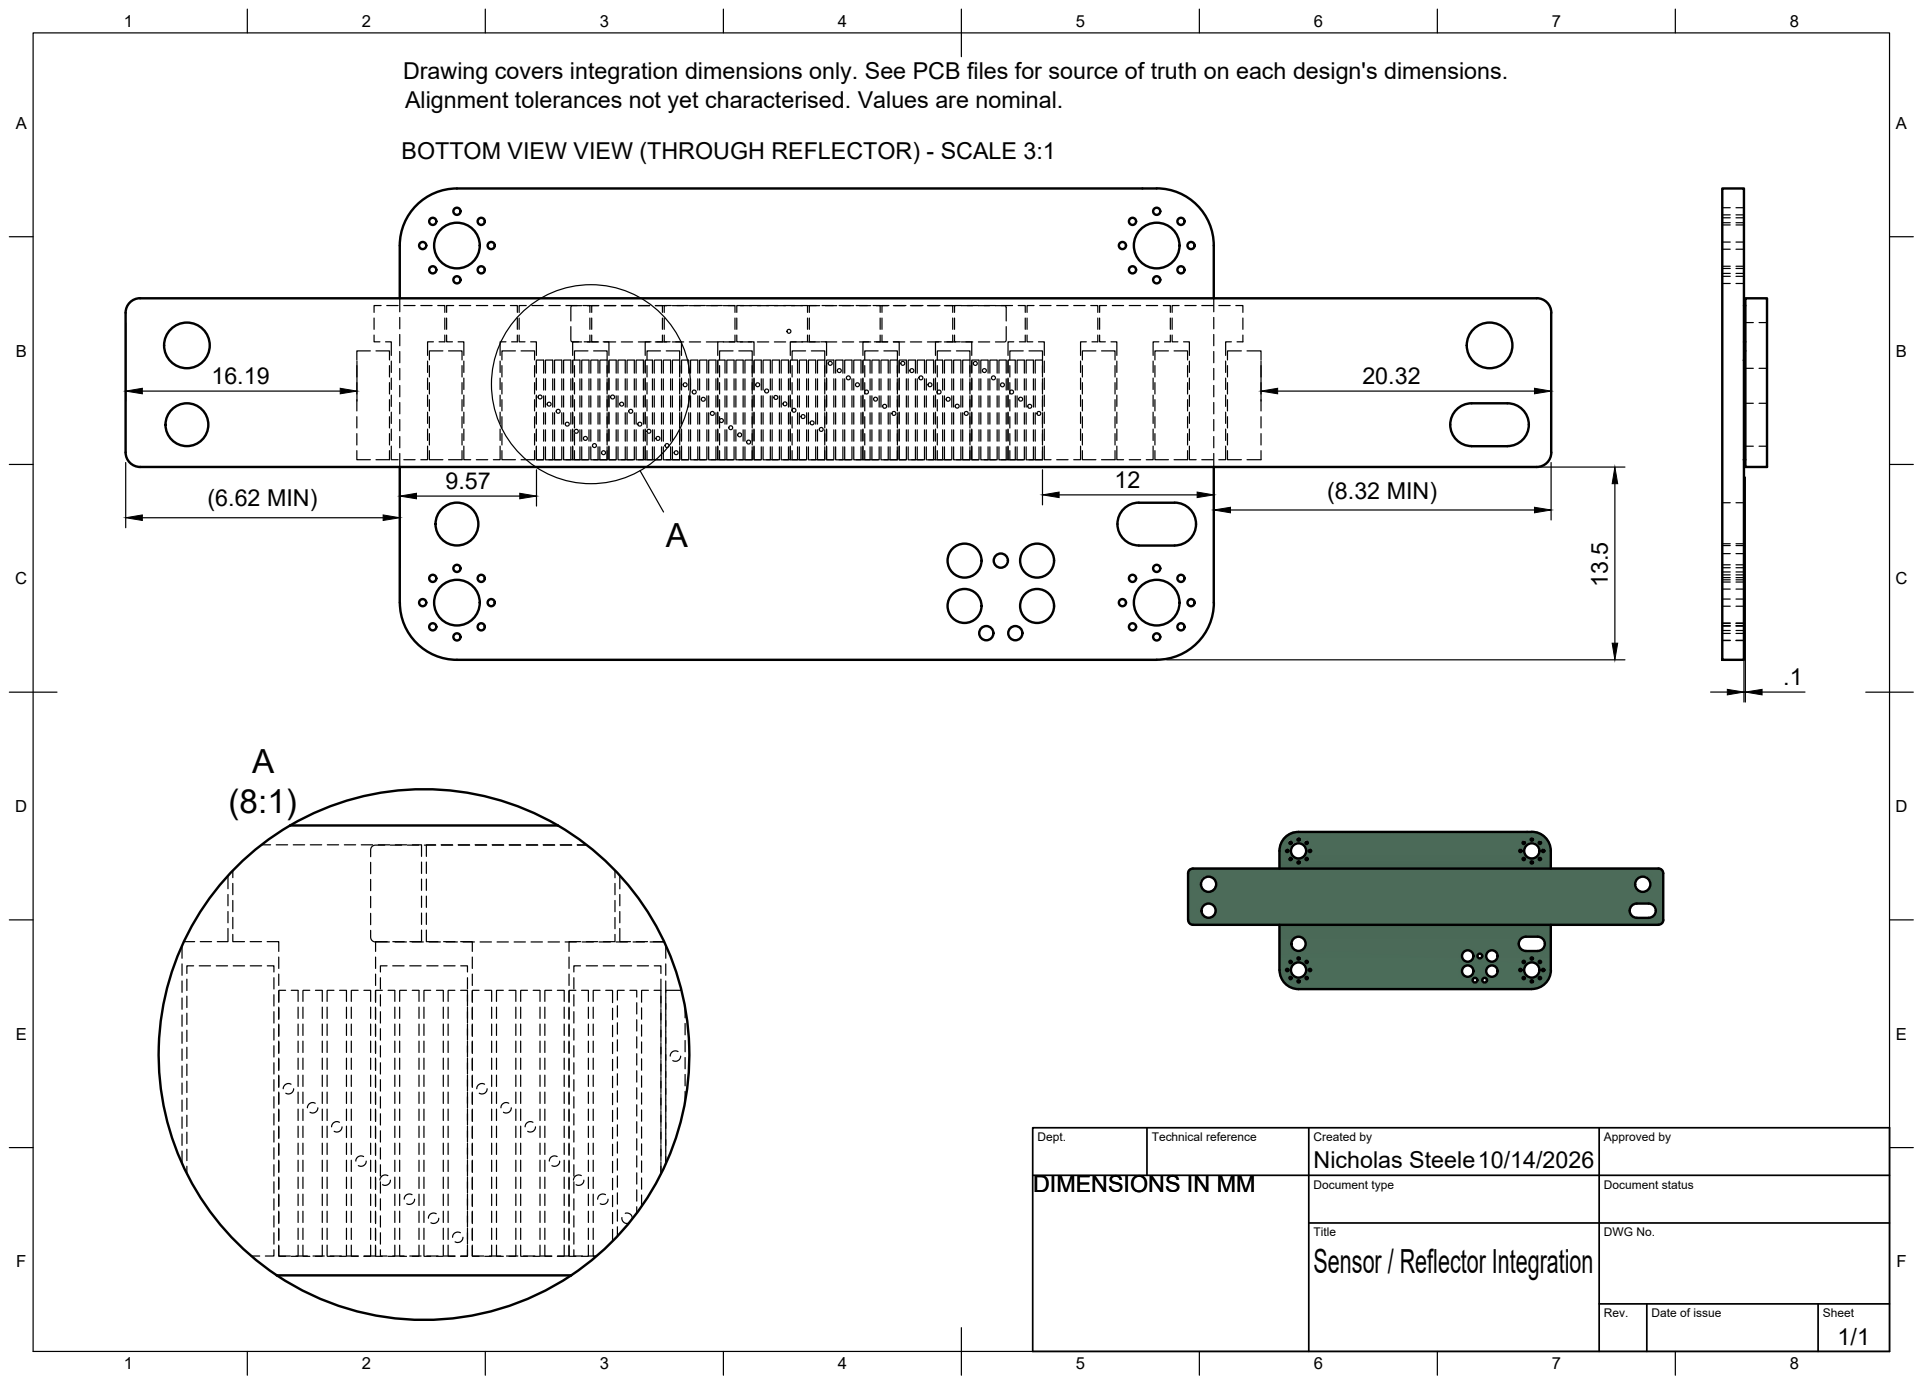
[picture p68: page 1]
Title; DWG No.; Rev.; Date of issue; Sheet; (6.62 MIN); (8.32 MIN)

Drawing covers integration dimensions only. See PCB files for source of truth on each design's dimensions.
Alignment tolerances not yet characterised. Values are nominal.

BOTTOM VIEW VIEW (THROUGH REFLECTOR) - SCALE 3:1

Dept. | Technical reference | Created by Nicholas Steele 10/14/2026 | Approved by

DIMENSIONS IN MM

Document type | Document status

Sensor / Reflector Integration
