nichlock/open-linear-scale/hardware/sensor-pcb/sensor-pcb.pdf

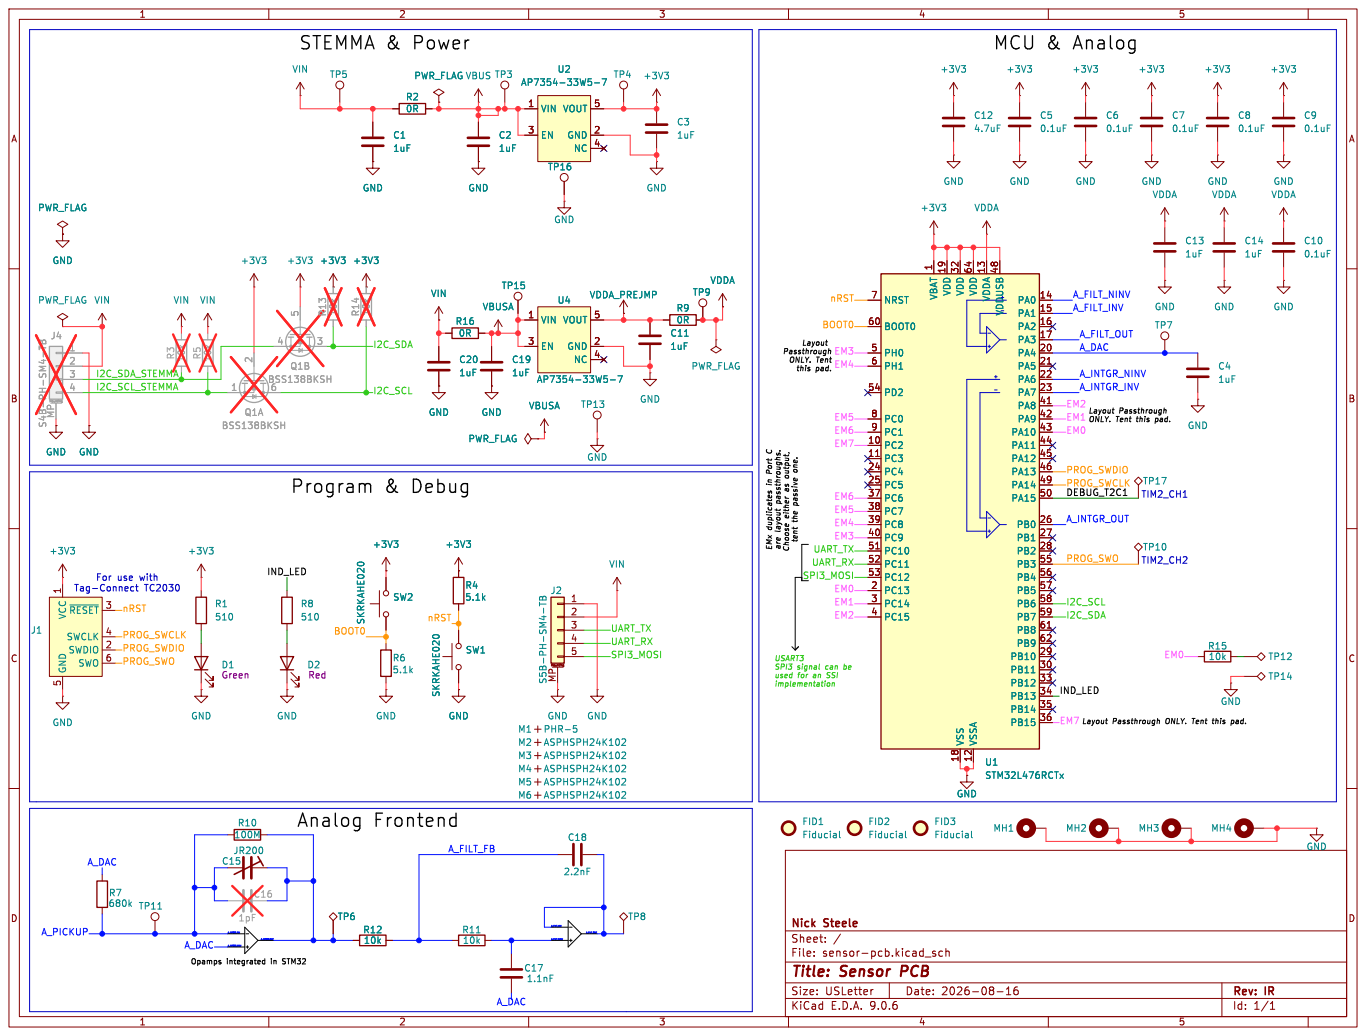
[picture p69: page 1]

1 VDD 19 VDD 32 VSS 18 VDD 64 VSSA 12 VDDA 13 VDDUSB 48 PA0 14 PA1 15 PA2 16 PA3 17 PA4 20 PA5 21 PA6 22 PA7 23 PA8 41 PA9 42 PA10 43 PA11 44 PA12 45 PA13 46 PA14 49 PA15 50 PB0 26 PB1 27 PB2 28 PB3 55 PB4 56 PB5 57 PB6 58 PB7 59 PB8 61 PB9 62 PB10 29 PB11 30 PB12 33 PB13 34 PB14 35 PB15 36 GND

1 VDD 19 VDD 32 VSS 18 VDD 64 VSSA 12 VDDA 13 VDDUSB 48 PA0 14 PA1 15 PA2 16 PA3 17 PA4 20 PA5 21 PA6 22 PA7 23 PA8 41 PA9 42 PA10 43 PA11 44 PA12 45 PA13 46 PA14 49 PA15 50 PB0 26 PB1 27 PB2 28 PB3 55 PB4 56 PB5 57 PB6 58 PB7 59 PB8 61 PB9 62 PB10 29 PB11 30 PB12 33 PB13 34 PB14 35 PB15 36 U1STM32L476RCTx
this pad. EMx duplicates in Port C are layout passthroughs. Choose either as output, tent the passive one.

Layout Passthrough ONLY. Tent

Layout Passthrough ONLY. Tent this pad. TIM2_CH1
EM0 PROG_SWDIO

5 ~{RESET}3 SWCLK 4 SWDIO 2 SWO 6

used for an SSI

File: sensor-pcb.kicad_sch Sheet: / Nick Steele

Id: 1/1 Title: Sensor PCB
