nichlock/open-linear-scale/hardware/sensor-pcb/sensor-pcb-assembly.pdf

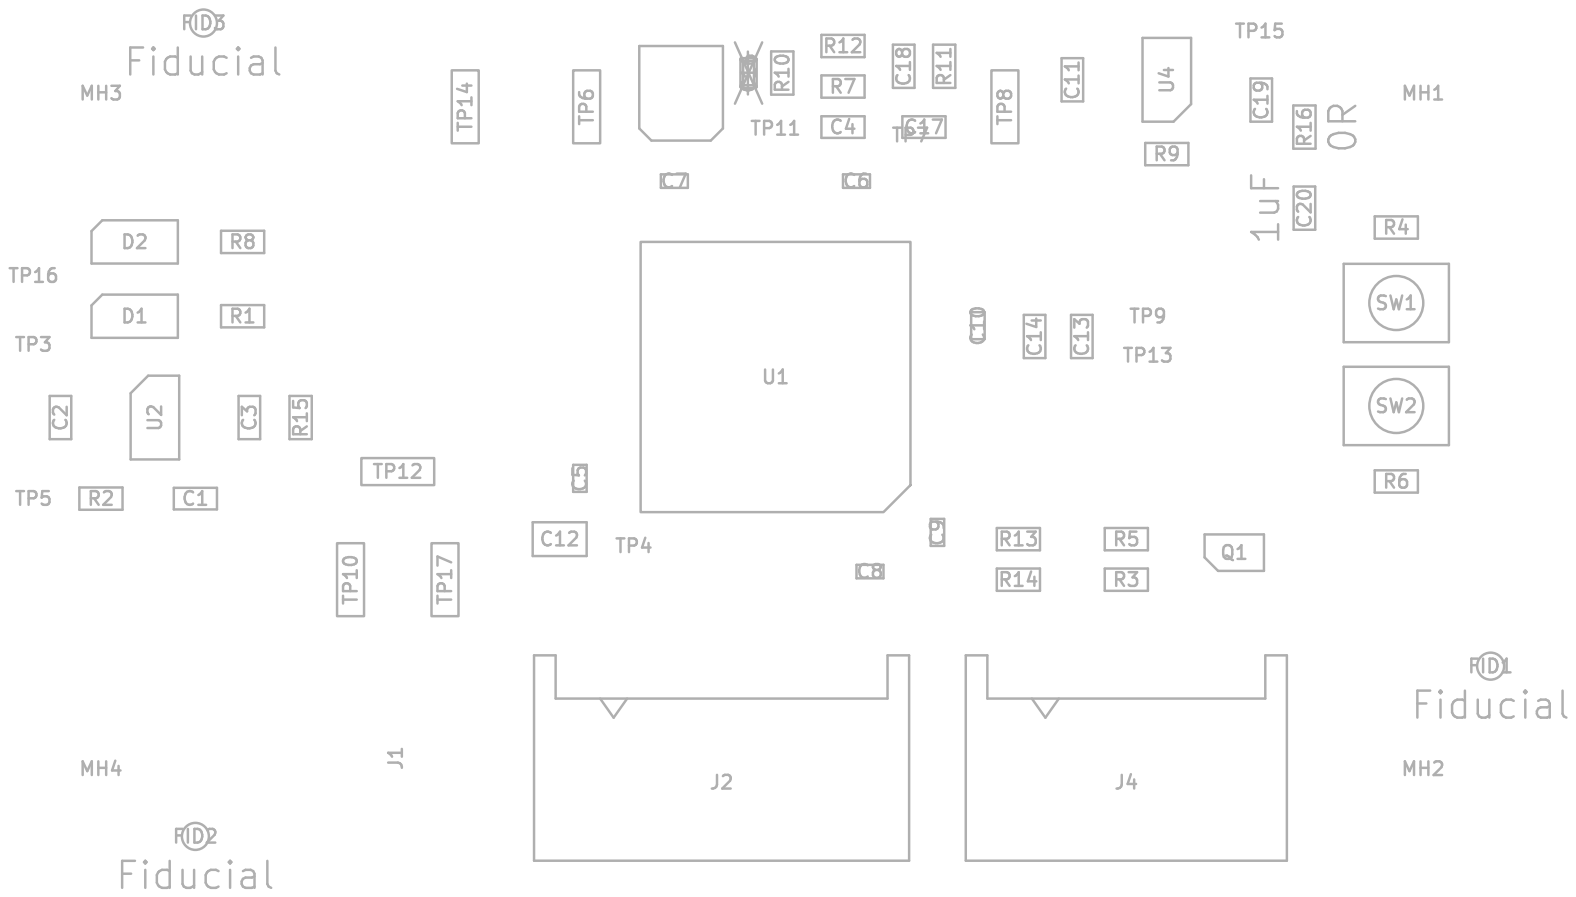
[picture p70: page 1]
