nichlock/open-linear-scale/hardware/sensor-pcb/sensor-pcb-schematic.pdf

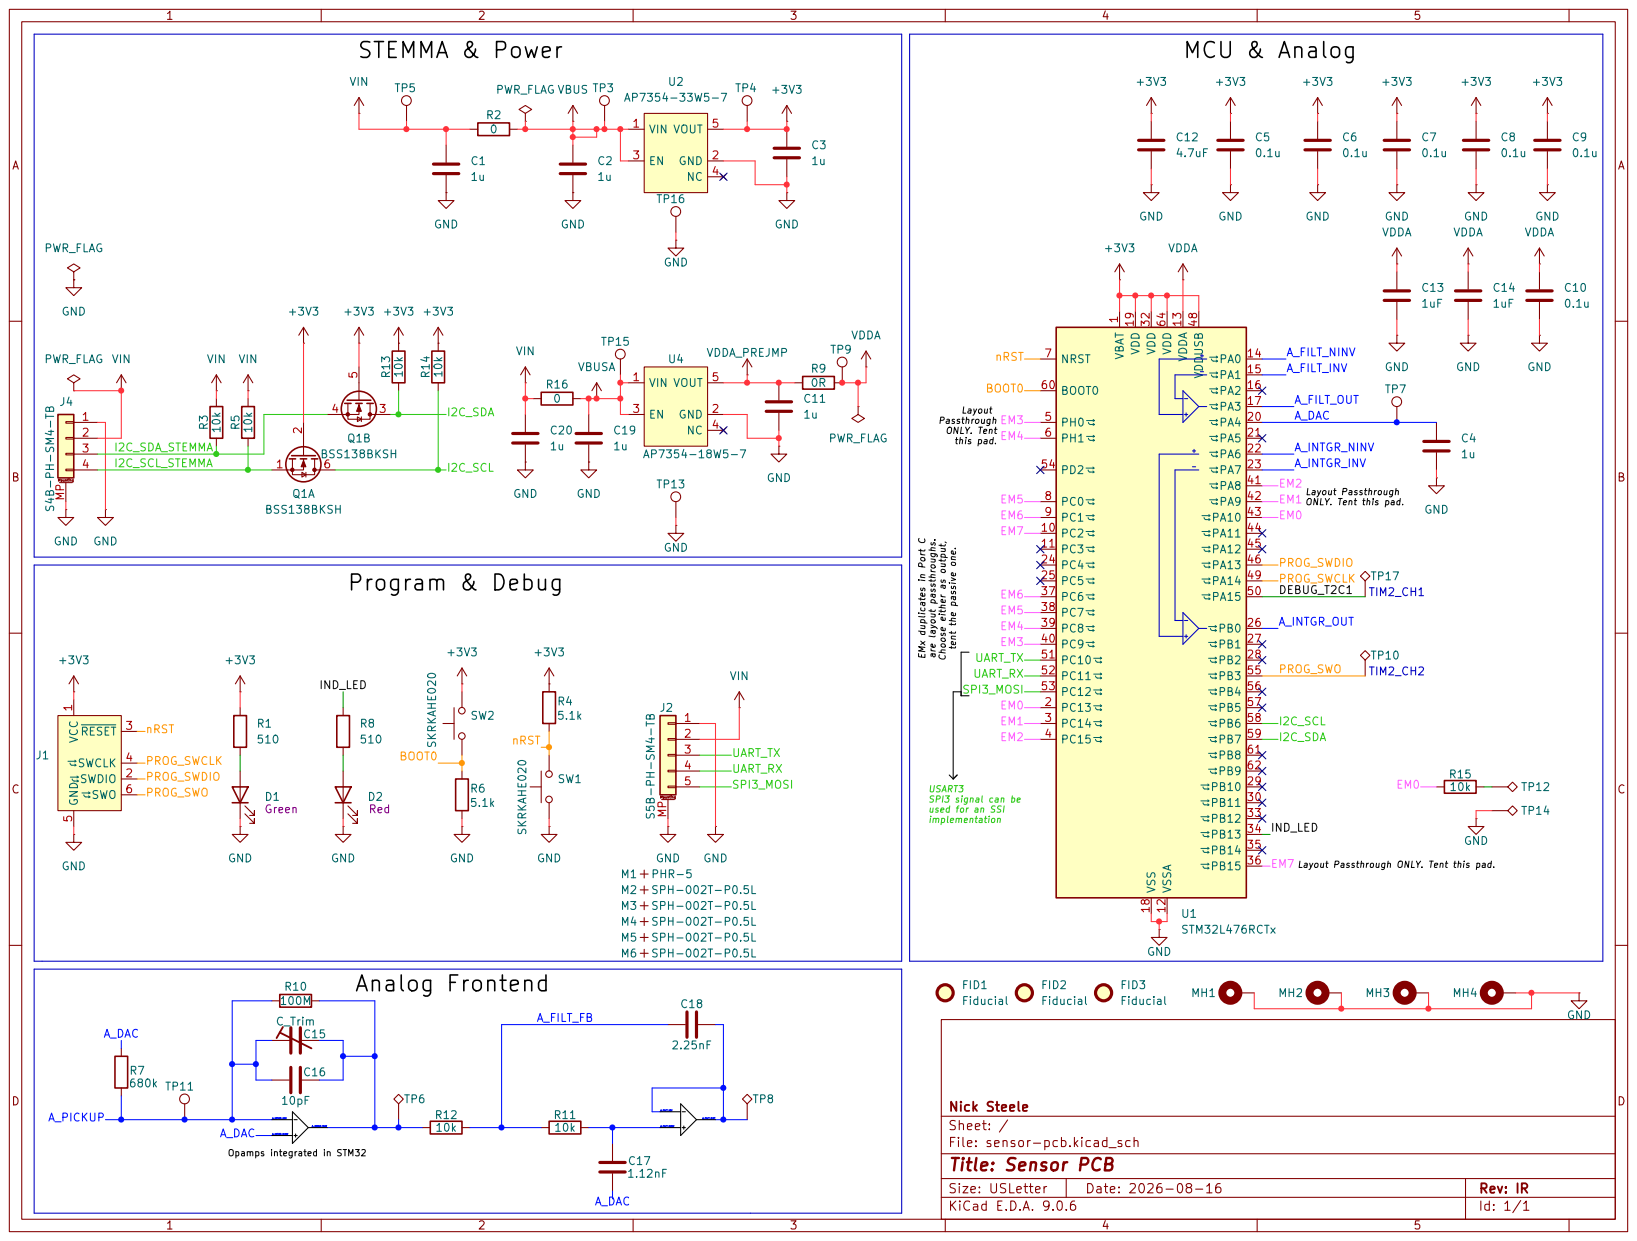
[picture p71: page 1]
