nichlock/open-linear-scale/hardware/sensor-pcb/sensor-pcb.kicad_pcb

## KiCad design hardware/sensor-pcb/sensor-pcb.kicad_pcb (2026-10-14)

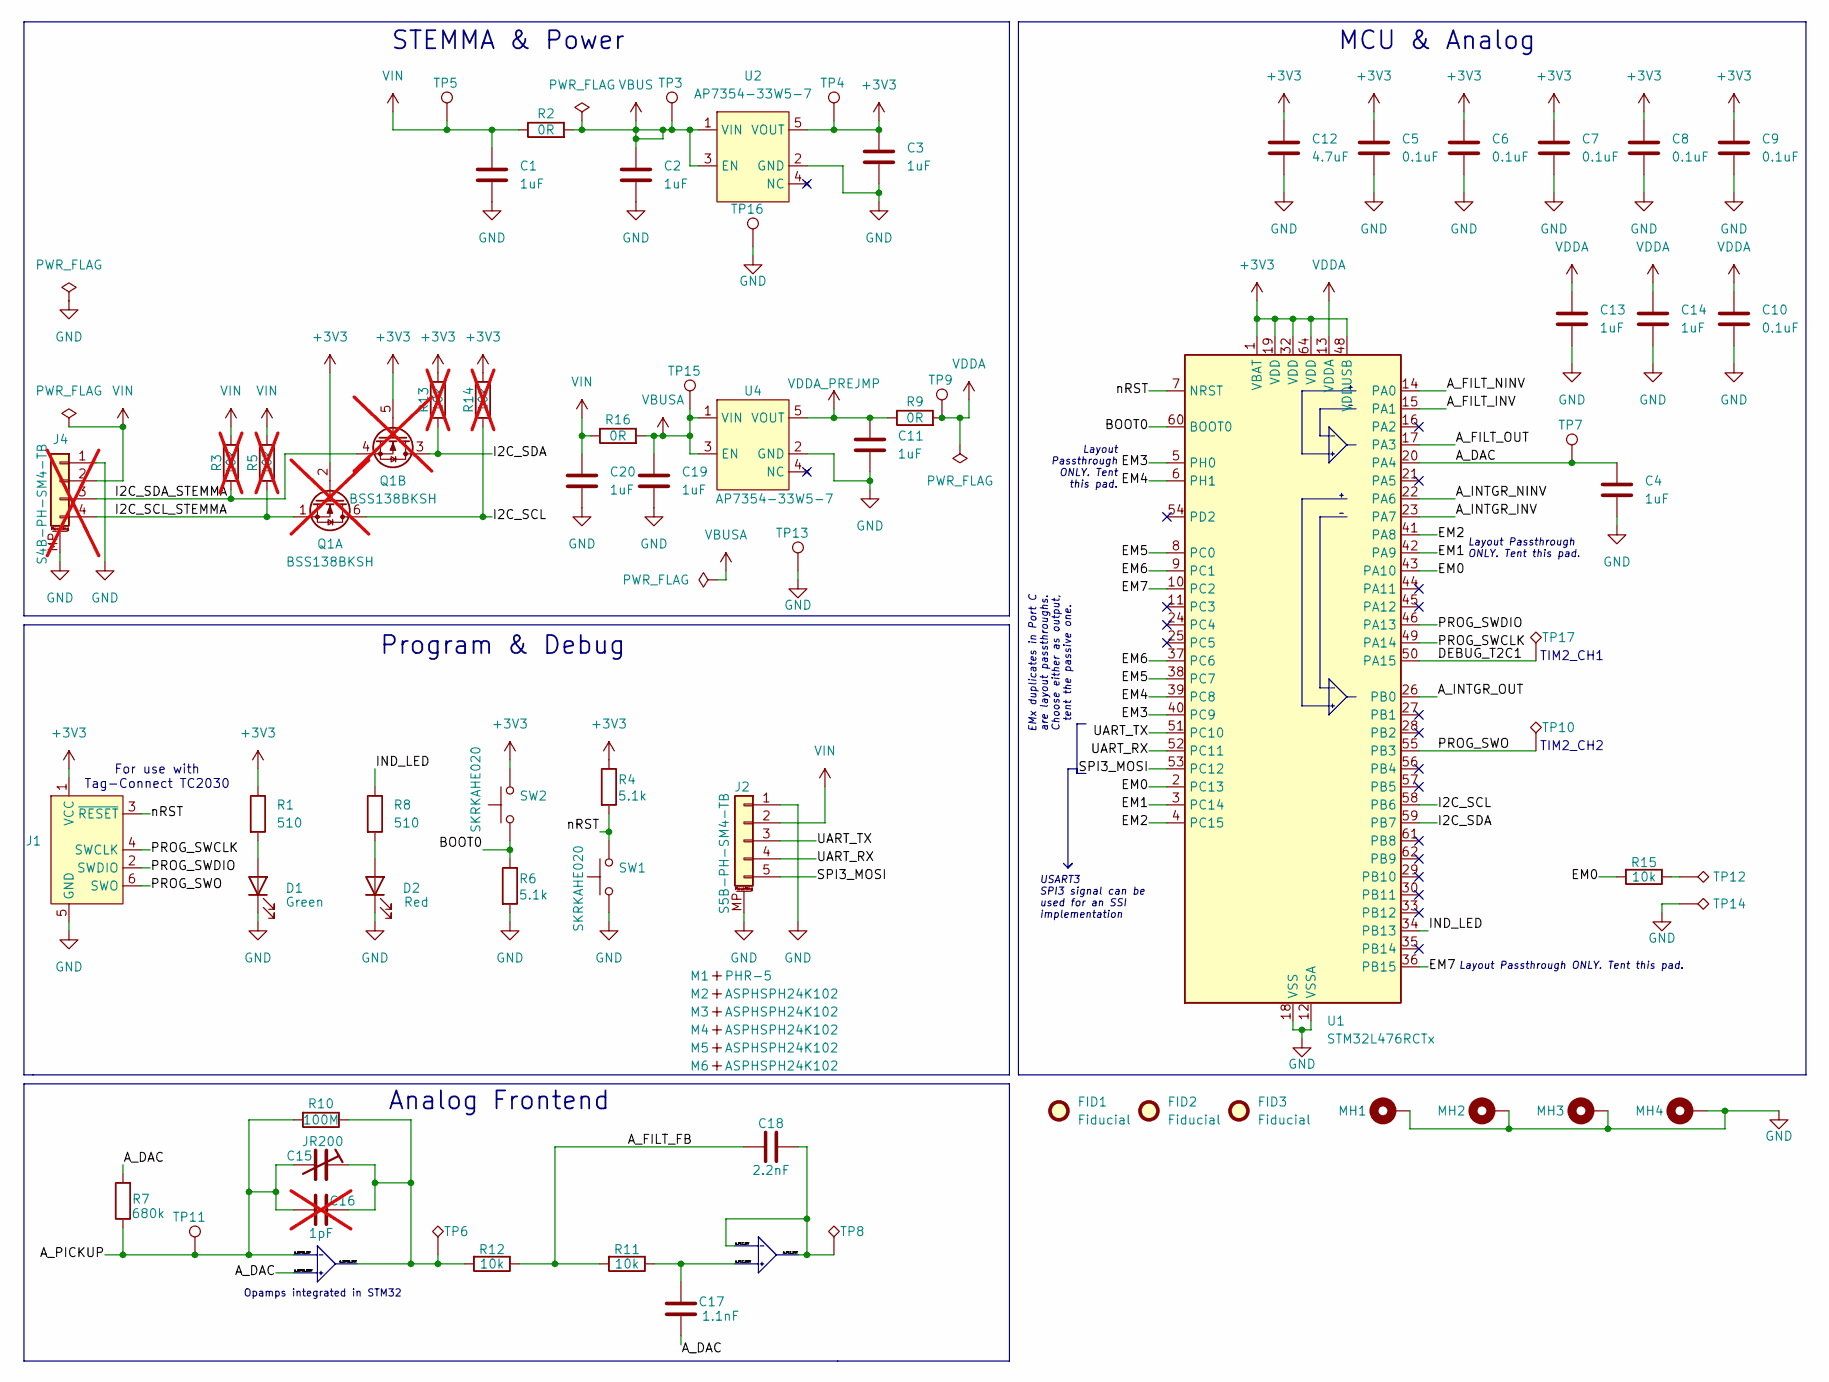
[picture p72: schematic sensor-pcb.kicad_sch, Sensor PCB]

Parts:
C1, C2, C3, C4, C11, C13, C14, C19, C20: 1uF; C_0603_1608Metric
C5, C6, C7, C8, C9, C10: 0.1uF; C_0402_1005Metric
C12: 4.7uF; C_0805_2012Metric
C15: JR200; JRx-trimmer
C16: 1pF; C_0402_1005Metric_Pad0.74x0.62mm_HandSolder; not fitted
C17: 1.1nF; C_0603_1608Metric
C18: 2.2nF; C_0603_1608Metric
D1: APT3216LZGCK; LED_1206_3216Metric
D2: APT3216LSECK/J3-PRV; LED_1206_3216Metric
FID1, FID2, FID3: Fiducial; Fiducial_0.5mm_Mask1mm
J1: Conn_ARM_SWD_TagConnect_TC2030; Tag-Connect_TC2030-IDC-FP_2x03_P1.27mm_Vertical
J2: S5B-PH-SM4-TB; JST_PH_S5B-PH-SM4-TB_1x05-1MP_P2.00mm_Horizontal
J4: S4B-PH-SM4-TB; JST_PH_S4B-PH-SM4-TB_1x04-1MP_P2.00mm_Horizontal; not fitted
M1: PHR-5
M2, M3, M4, M5, M6: ASPHSPH24K102
MH1, MH2, MH3, MH4: M3; MountingHole_3.2mm_M3_Pad_Via
Q1: BSS138BKSH; SOT-363_SC-70-6; not fitted
R1, R8: 510; R_0603_1608Metric
R2, R9, R16: 0R; R_0603_1608Metric
R3, R5, R13, R14: 10k; R_0603_1608Metric; not fitted
R4, R6: 5.1k; R_0603_1608Metric
R7: 680k; R_0603_1608Metric
R10: 100M; R_0603_1608Metric
R11, R12, R15: 10k; R_0603_1608Metric
SW1, SW2: SKRKAHE020; SW_Push_SPST_NO_Alps_SKRK
TP3, TP4, TP5, TP7, TP9, TP11, TP13, TP15, TP16: TestPoint; TestPoint_Pad_D1.0mm
TP6, TP8, TP10, TP12, TP14, TP17: TP_Keystone_5015; TestPoint_Keystone_5015_Micro_Mini
U1: STM32L476RCTx; LQFP-64_10x10mm_P0.5mm
U2, U4: AP7354-33W5-7; SOT-23-5_HandSoldering

Connections:
+3V3: C3.1, C5.1, C6.1, C7.1, C8.1, C9.1, C12.1, J1.1 (VCC), Q1.2 (G), Q1.5 (G), R1.1, R4.1, R13.1, R14.1, SW2.2, TP4.1, U1.1 (VBAT), U1.19 (VDD), U1.32 (VDD), U1.48 (VDDUSB), U1.64 (VDD), U2.5 (VOUT)
/A_DAC: C4.1, C17.2, R7.2, TP7.1, U1.20 (PA4), U1.22 (PA6)
/A_FILT_FB: C18.2, R11.2, R12.1
/A_FILT_INV: C18.1, TP8.1, U1.15 (PA1), U1.17 (PA3)
/A_FILT_NINV: C17.1, R11.1, U1.14 (PA0)
/A_INTGR_INV: C15.2, C16.1, R7.1, R10.2, TP11.1, U1.23 (PA7)
/A_INTGR_OUT: C15.1, C16.2, R10.1, R12.2, TP6.1, U1.26 (PB0)
/BOOT0: R6.1, SW2.1, U1.60 (BOOT0)
/DEBUG_T2C1: TP17.1, U1.50 (PA15)
/EM0: R15.2, U1.2 (PC13), U1.43 (PA10)
/EM1: U1.3 (PC14), U1.42 (PA9)
/EM2: U1.4 (PC15), U1.41 (PA8)
/EM3: U1.5 (PH0), U1.40 (PC9)
/EM4: U1.6 (PH1), U1.39 (PC8)
/EM5: U1.8 (PC0), U1.38 (PC7)
/EM6: U1.9 (PC1), U1.37 (PC6)
/EM7: U1.10 (PC2), U1.36 (PB15)
/I2C_SCL: Q1.6 (D), R14.2, U1.58 (PB6)
/I2C_SCL_STEMMA: J4.4, Q1.1 (S), R5.2
/I2C_SDA: Q1.3 (D), R13.2, U1.59 (PB7)
/I2C_SDA_STEMMA: J4.3, Q1.4 (S), R3.2
/IND_LED: R8.1, U1.34 (PB13)
/PROG_SWCLK: J1.4 (SWCLK), U1.49 (PA14)
/PROG_SWDIO: J1.2 (SWDIO), U1.46 (PA13)
/PROG_SWO: J1.6 (SWO), TP10.1, U1.55 (PB3)
/SPI3_MOSI: J2.5, U1.53 (PC12)
/UART_RX: J2.4, U1.52 (PC11)
/UART_TX: J2.3, U1.51 (PC10)
/nRST: J1.3 (~RESET), R4.2, SW1.2, U1.7 (NRST)
GND: C1.2, C2.2, C3.2, C4.2, C5.2, C6.2, C7.2, C8.2, C9.2, C10.2, C11.2, C12.2, C13.2, C14.2, C19.2, C20.2, D1.1 (K), D2.1 (K), J1.5 (GND), J2.1, J2.MP (MountPin), J4.1, J4.MP (MountPin), MH1.1, MH2.1, MH3.1, MH4.1, R6.2, SW1.1, TP13.1, TP14.1, TP16.1, U1.12 (VSSA), U1.18 (VSS), U1.31 (VSS), U1.47 (VSS), U1.63 (VSS), U2.2 (GND), U4.2 (GND)
unnamed: D1.2 (A), R1.2
unnamed: D2.2 (A), R8.2
unnamed: R15.1, TP12.1
VBUS: C2.1, R2.2, TP3.1, U2.1 (VIN), U2.3 (EN)
VBUSA: C19.1, R16.2, TP15.1, U4.1 (VIN), U4.3 (EN)
VDDA: C10.1, C13.1, C14.1, R9.2, TP9.1, U1.13 (VDDA)
VDDA_PREJMP: C11.1, R9.1, U4.5 (VOUT)
VIN: C1.1, C20.1, J2.2, J4.2, R2.1, R3.1, R5.1, R16.1, TP5.1

Notes on the sheet:
TIM2_CH2
Opamps integrated in STM32
STEMMA & Power
MCU & Analog
Analog Frontend
EMx duplicates in Port C are layout passthroughs. Choose either as output, tent the passive one.
USART3 SPI3 signal can be used for an SSI implementation
Layout Passthrough ONLY. Tent this pad.
Layout Passthrough ONLY. Tent this pad.
Layout Passthrough ONLY. Tent this pad.
Program & Debug
TIM2_CH1
For use with Tag-Connect TC2030

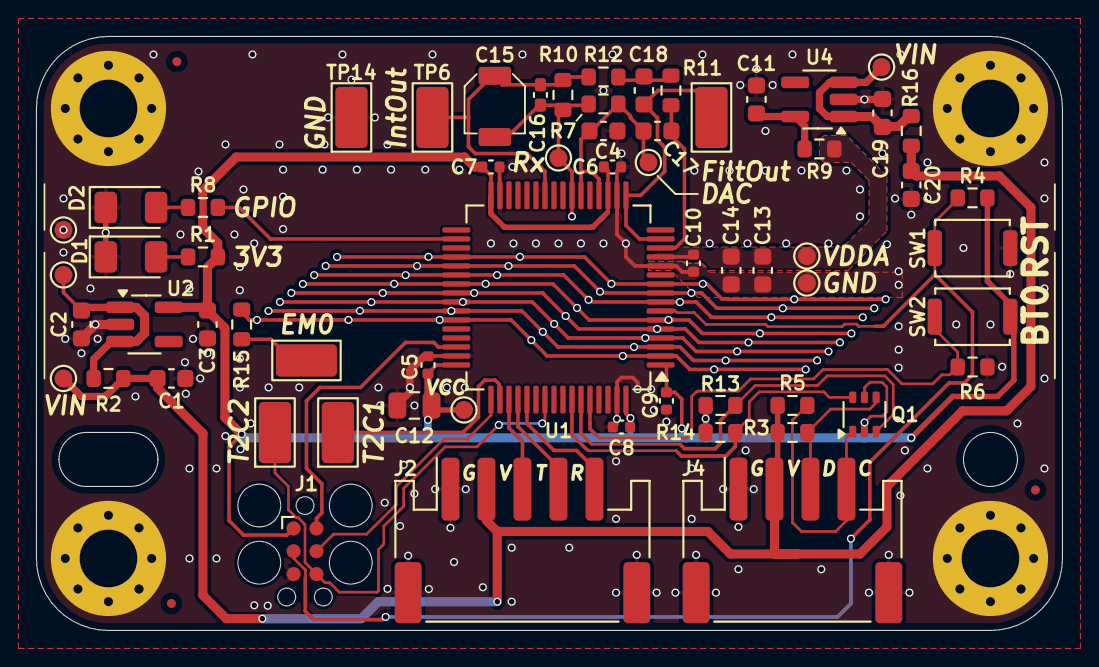
[picture p73: board sensor-pcb.kicad_pcb from above]

Board: 4 copper layers, 57.0 x 33.0 mm, 69 parts (0 on the bottom side), 38 nets.
