nichlock/open-linear-scale/(commit log)

2026-09-23 Created Sensor PCB and two lengths of reflector PCBs.
2026-10-03 Created rev b reflector PCB
    WAS: The widths of the stems of the T's is equal to four emitter traces plus three emitter clearances (95mil).
    IS: The widths of the stems of the T's is equal to four emitter traces plus four emitter clearances (100mil).
    The hope is to remove the fringing error I'm seeing on my real boards.
2026-10-03 Created more PDF exports from kicad
2026-10-05 Create SensorAlgorithms register
2026-10-06 Debugging commit. Add PROCESS_START_STEP, changed interrupt approach for safePullReadings
2026-10-06 Change BSRR writes to DMA. Remove TIM2 interrupt.
2026-10-11 Create framework for additional README's
2026-10-12 Removed 2 layer sensor PCB
2026-10-12 Reworked sensor-PCB schematic/layout output jobs
2026-10-12 Reworked reflector-pcb output jobs
2026-10-13 Added ERC configuration and updated BOM settings in reflector PCB design
2026-10-13 Fixed sensor PCB 3D cad links that were dropped.
2026-10-13 Add pinout diagram. Update kicad outputs. Removed step files for now.
2026-10-14 Implemented kicad CI/CD. Removed committed exports except schematic PDF.
2026-10-14 Brought back sensor position code and added output for floating point position.
2026-10-15 Update license detail for STM32.
